8076ducc/robocup-2023/electrical design/symbols and footprints/STM32F103CBT6/STM32F103CBT6.step

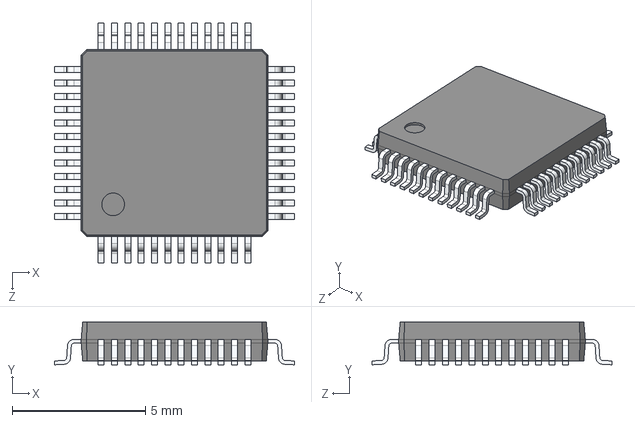
[picture p16: CAD file, 2022-08-24]
electrical design/symbols and footprints/STM32F103CBT6/STM32F103CBT6.step
9.00 x 1.60 x 9.00 mm
