8076ducc/robocup-2023/electrical design/symbols and footprints/VNH5050A-E/VNH5050A-E.step

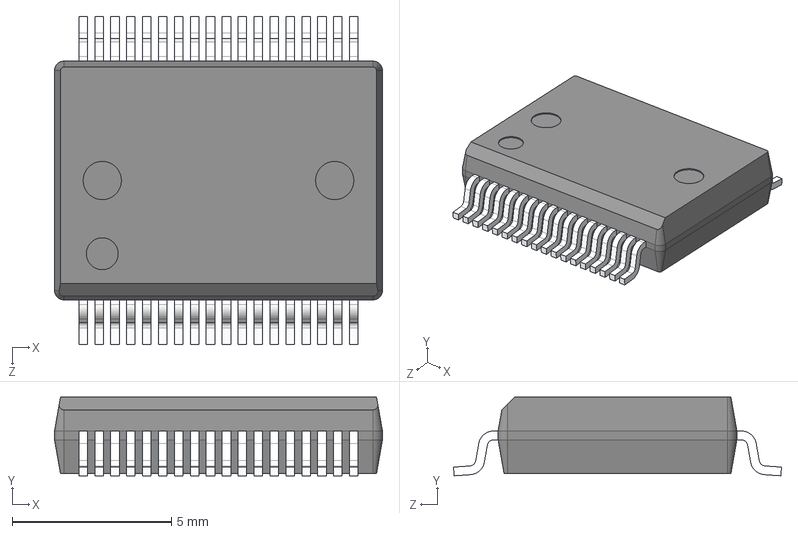
[picture p17: CAD file, 2022-08-24]
electrical design/symbols and footprints/VNH5050A-E/VNH5050A-E.step
10.3 x 2.47 x 10.3 mm
