8076ducc/robocup-2023/electrical design/symbols and footprints/XT60PW-M/XT60PW-M.step

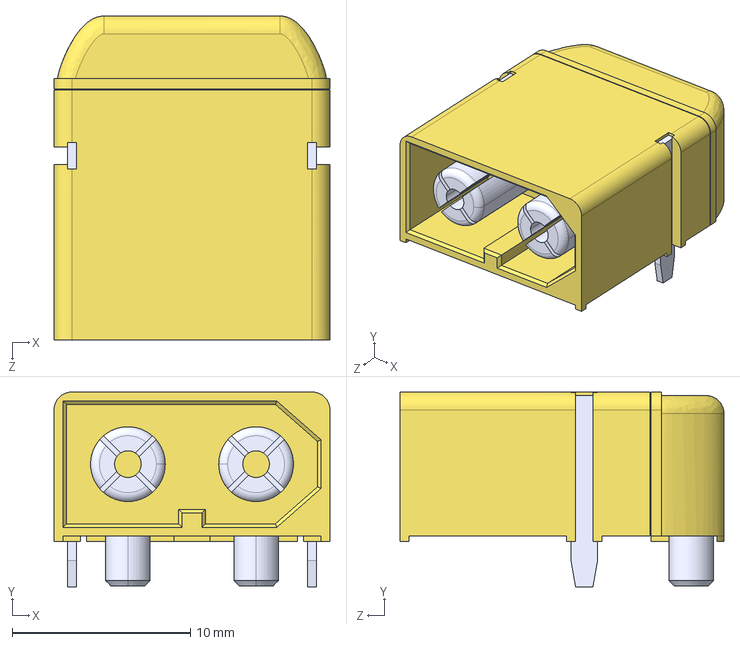
[picture p18: CAD file, 2023-02-03]
electrical design/symbols and footprints/XT60PW-M/XT60PW-M.step
15.5 x 10.9 x 18.2 mm
