8076ducc/robocup-2023/mechanical design/boards/driver.dxf

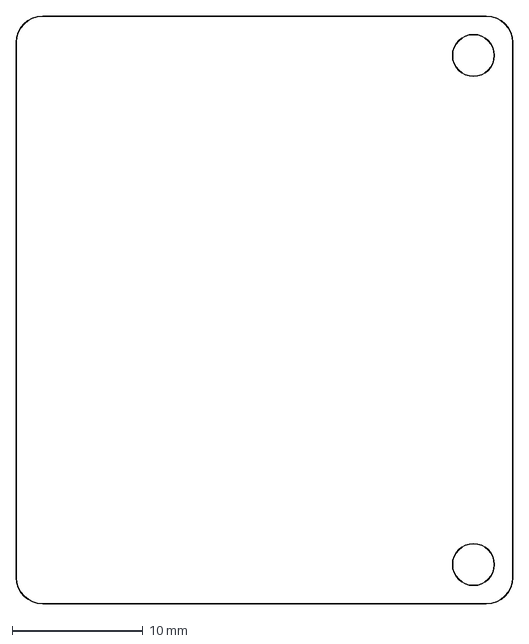
[picture p19: CAD file, 2023-04-10]
mechanical design/boards/driver.dxf
38.0 x 45.0 mm
