8076ducc/robocup-2023/mechanical design/dribbler/right-plate.stl

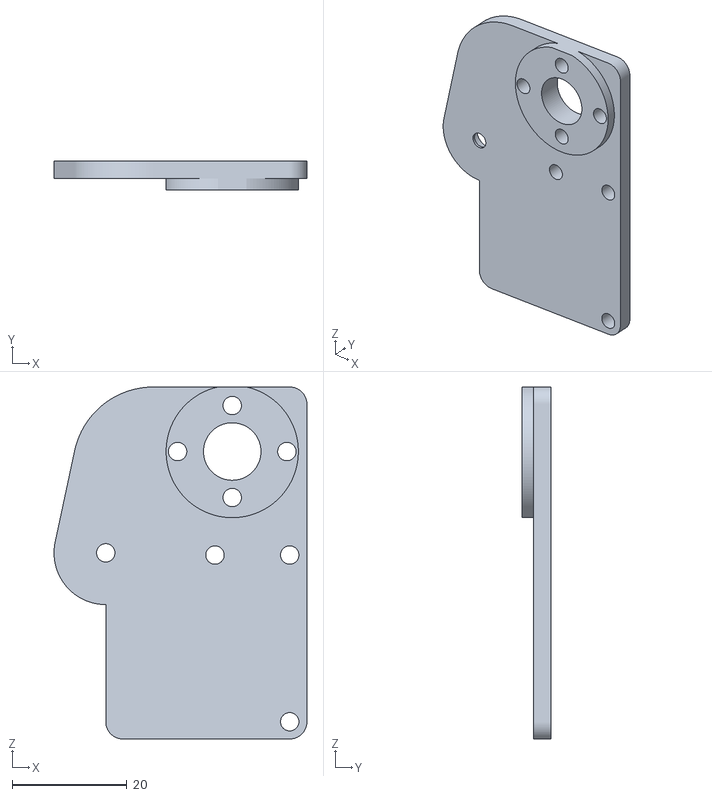
[picture p20: CAD file, 2022-08-31]
mechanical design/dribbler/right-plate.stl
44.0 x 5.00 x 61.2
