8076ducc/robocup-2023/mechanical design/motor mount/motor mount (lower half).stl

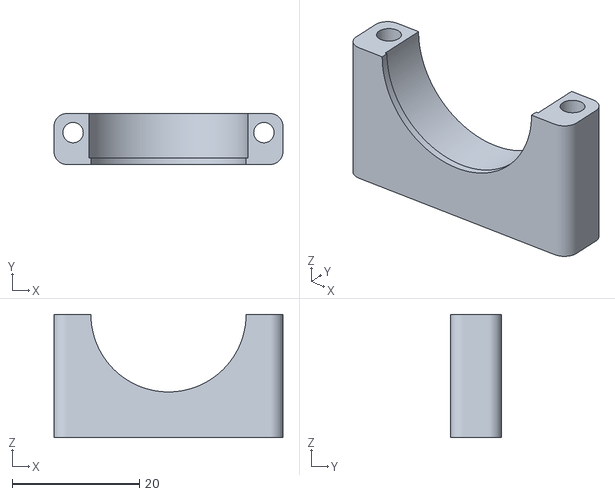
[picture p21: CAD file, 2023-04-07]
mechanical design/motor mount/motor mount (lower half).stl
36.0 x 8.00 x 19.4
