8076ducc/robocup-2023/mechanical design/omniwheel/roller.stl

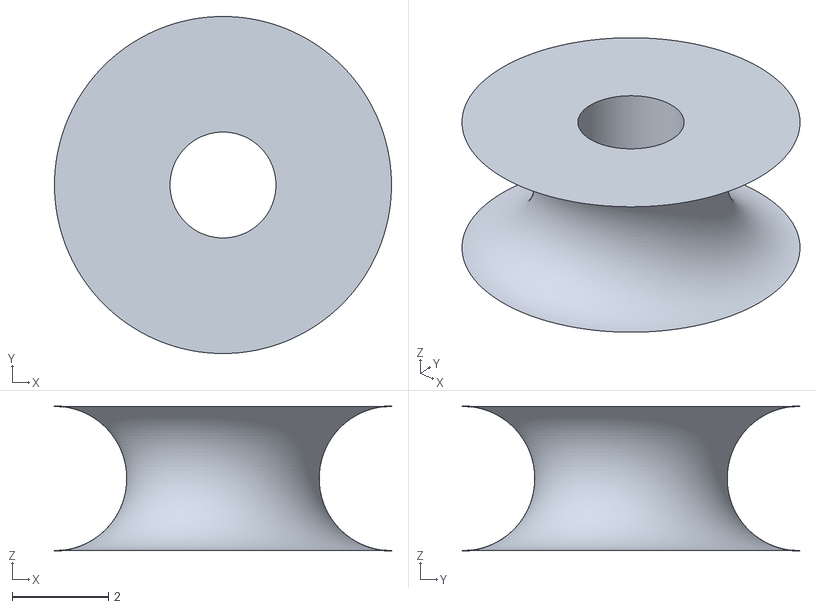
[picture p22: CAD file, 2023-04-07]
mechanical design/omniwheel/roller.stl
7.00 x 7.00 x 3.00
