8076ducc/robocup-2023/mechanical design/boards/layer5.dxf

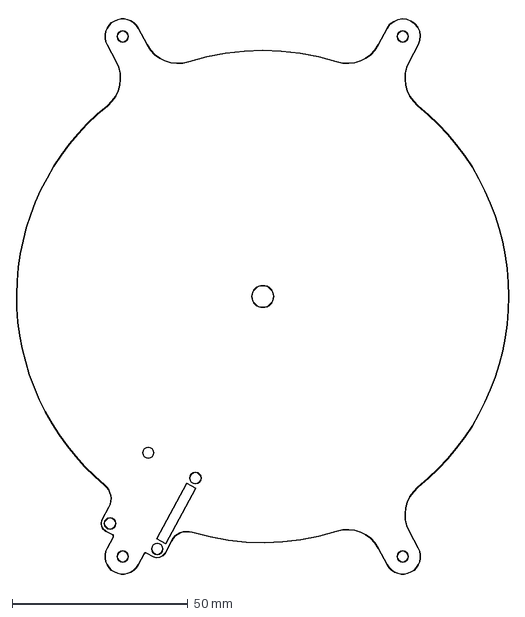
[picture p23: CAD file, 2023-04-10]
mechanical design/boards/layer5.dxf
140.1 x 159.3 mm
