8076ducc/robocup-2023/mechanical design/dribbler/left-plate.stl

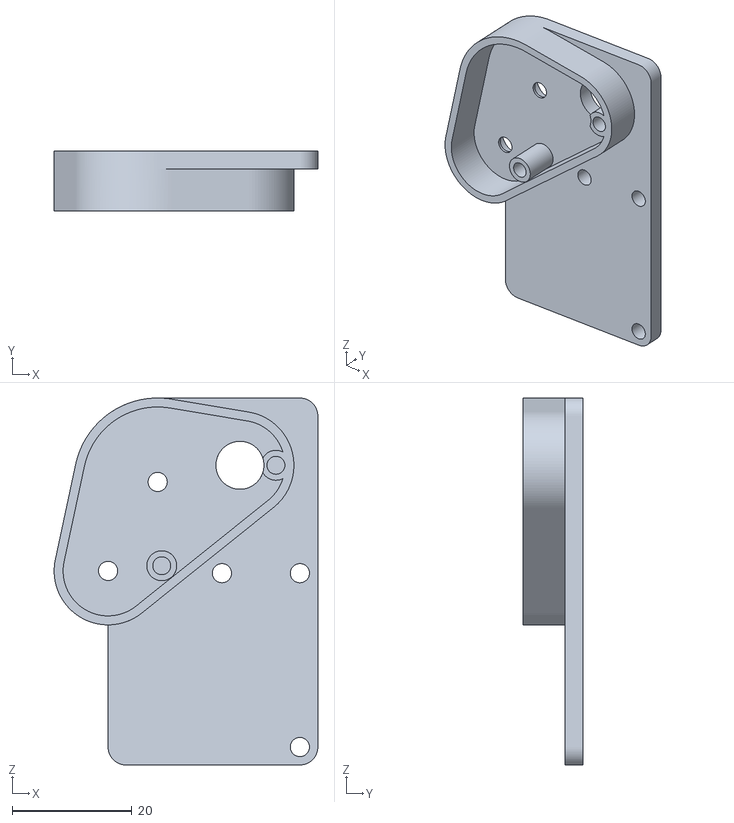
[picture p24: CAD file, 2022-08-26]
mechanical design/dribbler/left-plate.stl
44.0 x 10.0 x 61.2
