8076ducc/robocup-2023/mechanical design/motor mount/motor mount (upper half).stl

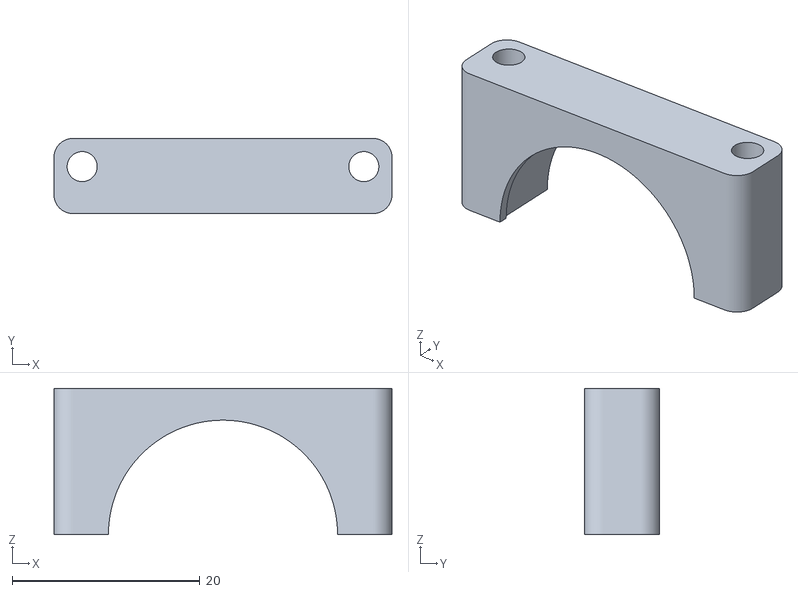
[picture p25: CAD file, 2023-04-07]
mechanical design/motor mount/motor mount (upper half).stl
36.0 x 8.00 x 15.6
