8076ducc/robocup-2023/mechanical design/omniwheel/omniwheel layer 3.stl

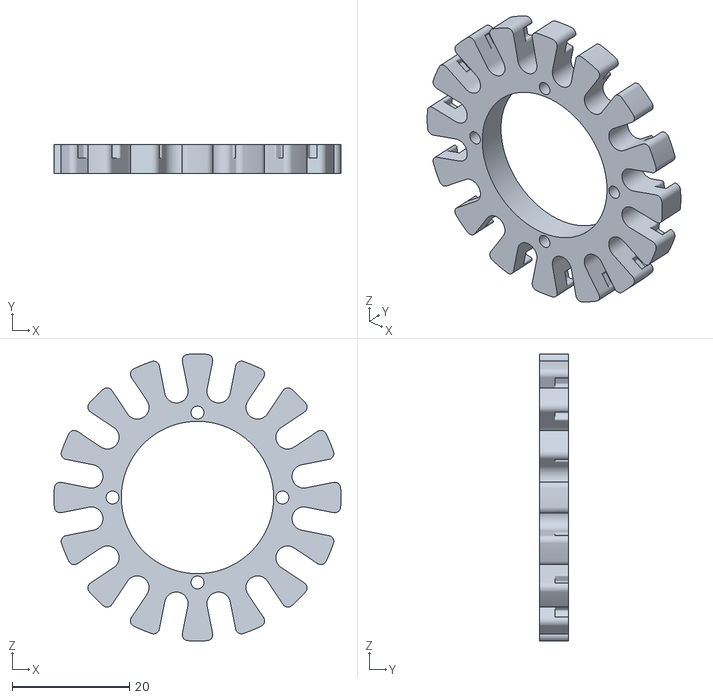
[picture p26: CAD file, 2023-04-07]
mechanical design/omniwheel/omniwheel layer 3.stl
49.0 x 5.00 x 49.0
