8076ducc/robocup-2023/mechanical design/boards/layer1.dxf

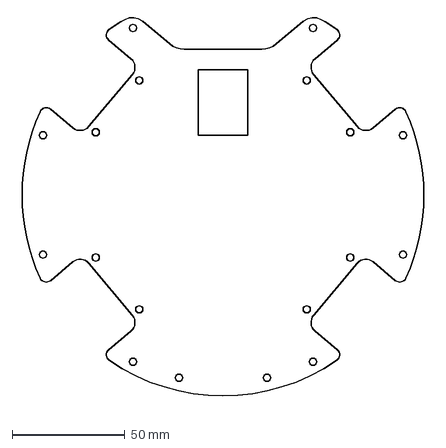
[picture p27: CAD file, 2023-02-15]
mechanical design/boards/layer1.dxf
183.3 x 173.3 mm
