8076ducc/robocup-2023/mechanical design/dribbler/gearbox-cover.stl

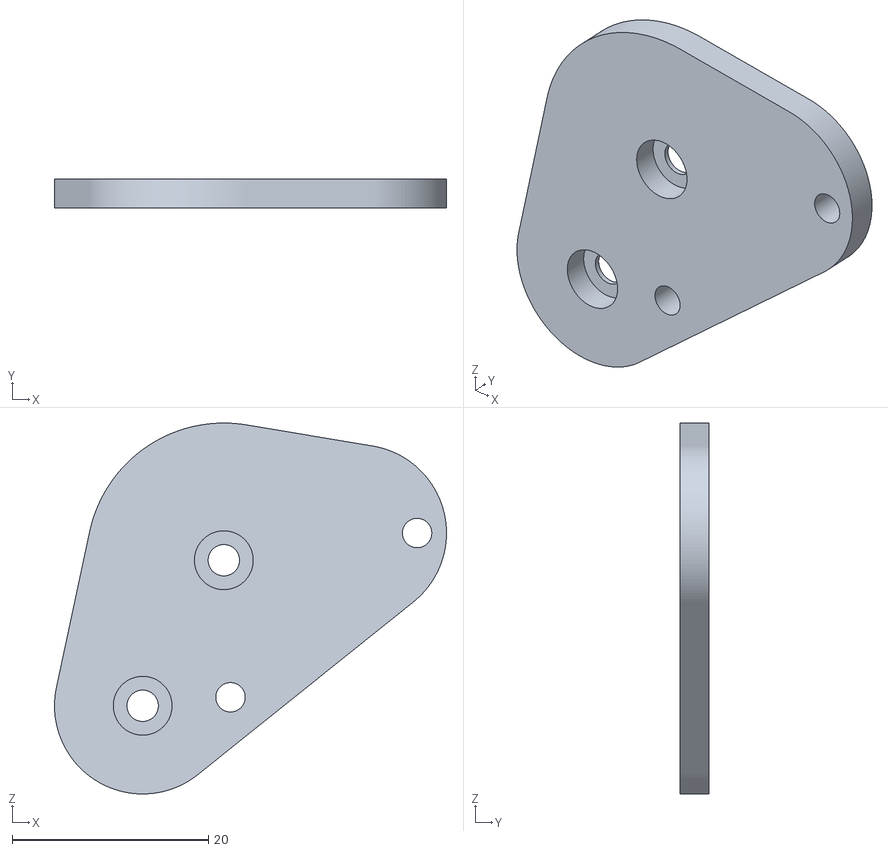
[picture p28: CAD file, 2022-08-26]
mechanical design/dribbler/gearbox-cover.stl
40.0 x 3.00 x 37.8
