8076ducc/robocup-2023/mechanical design/omniwheel/omniwheel layer 1.stl

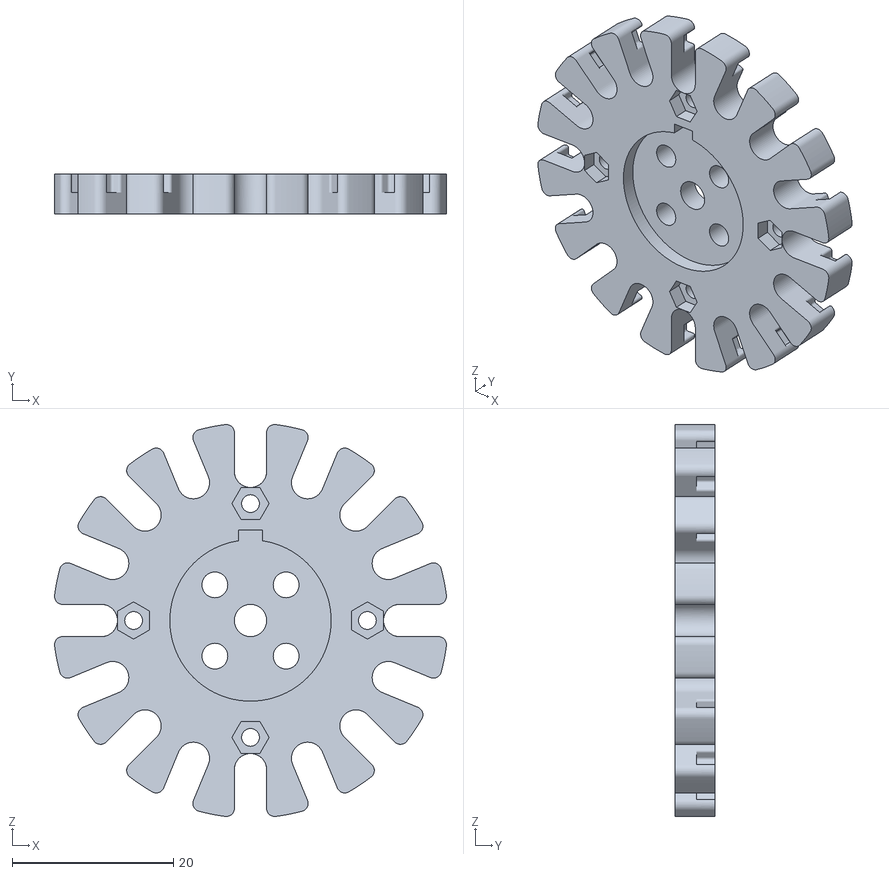
[picture p29: CAD file, 2023-04-07]
mechanical design/omniwheel/omniwheel layer 1.stl
48.6 x 5.00 x 48.6
