8076ducc/robocup-2023/mechanical design/boards/layer3.dxf

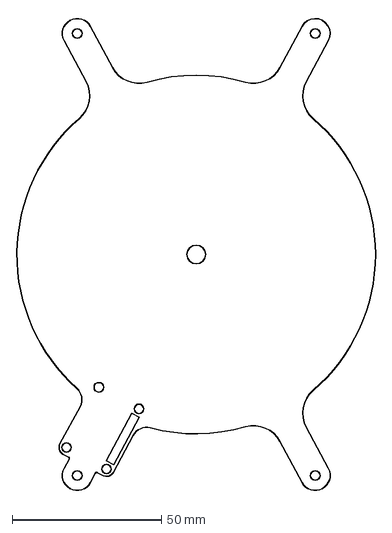
[picture p30: CAD file, 2023-02-15]
mechanical design/boards/layer3.dxf
120.2 x 159.3 mm
