8076ducc/robocup-2023/mechanical design/omniwheel/omniwheel layer 4.stl

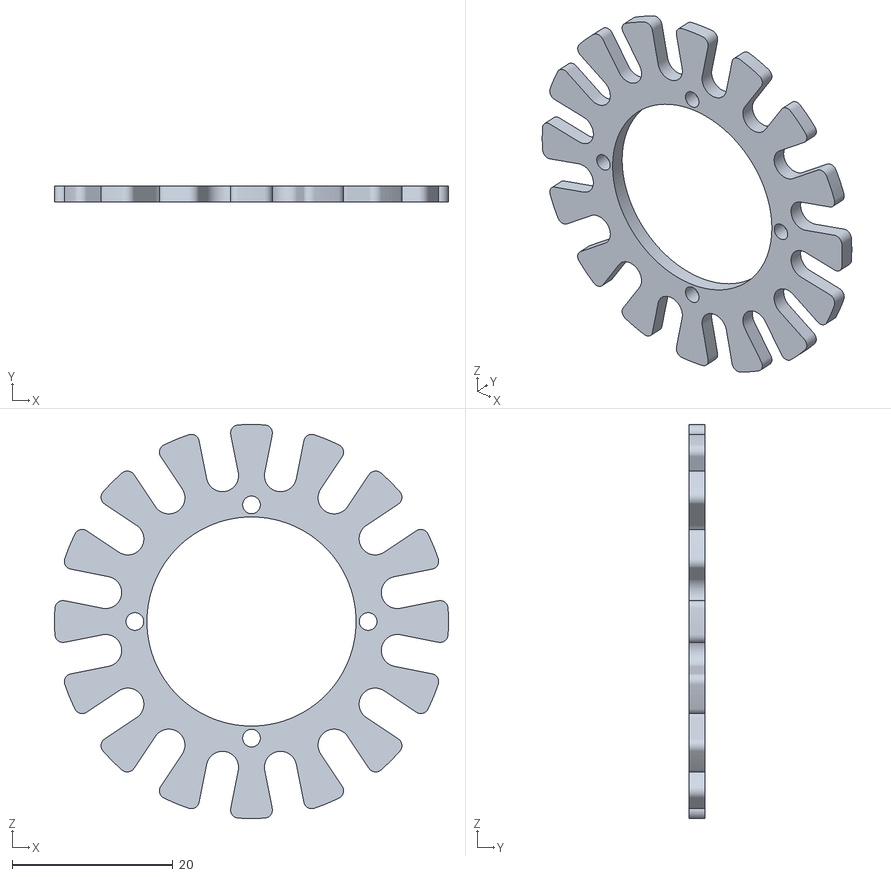
[picture p31: CAD file, 2023-04-07]
mechanical design/omniwheel/omniwheel layer 4.stl
49.0 x 2.00 x 49.0
