8076ducc/robocup-2023/(list of files, cad)

Other CAD files:
mechanical design/omniwheel/omniwheel layer 2.stl
