8076ducc/robocup-2023/electrical design/driver/pcb (back).pdf

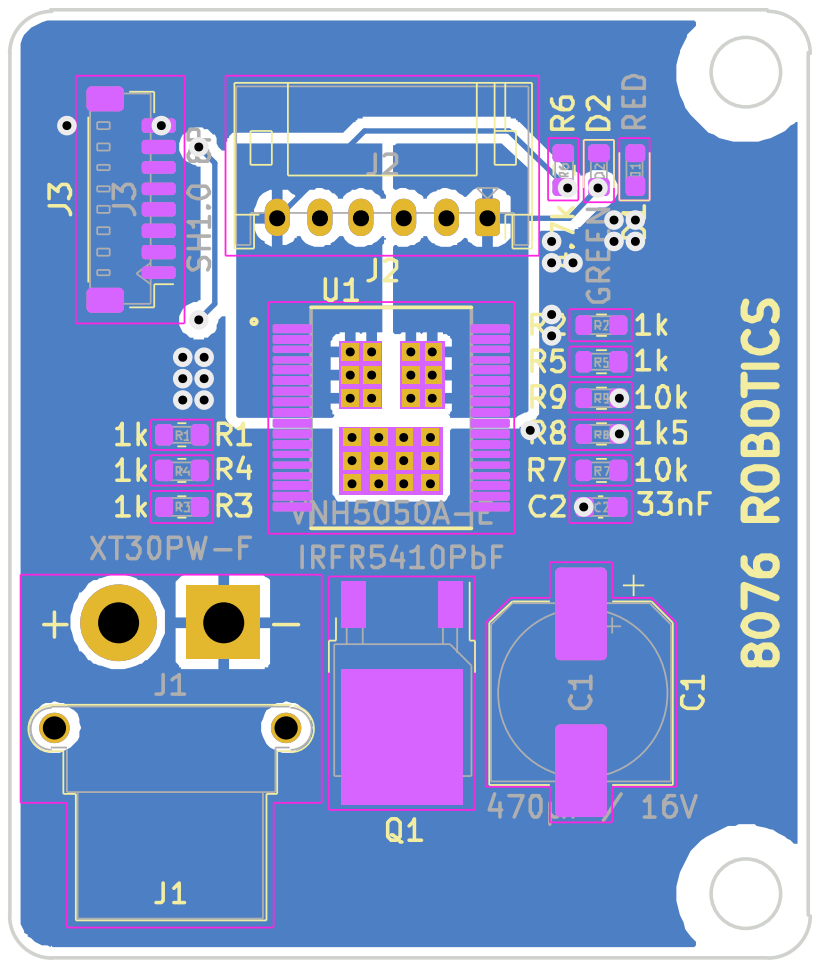
[picture p33: page 1]
