8076ducc/robocup-2023/electrical design/driver/pcb (front).pdf

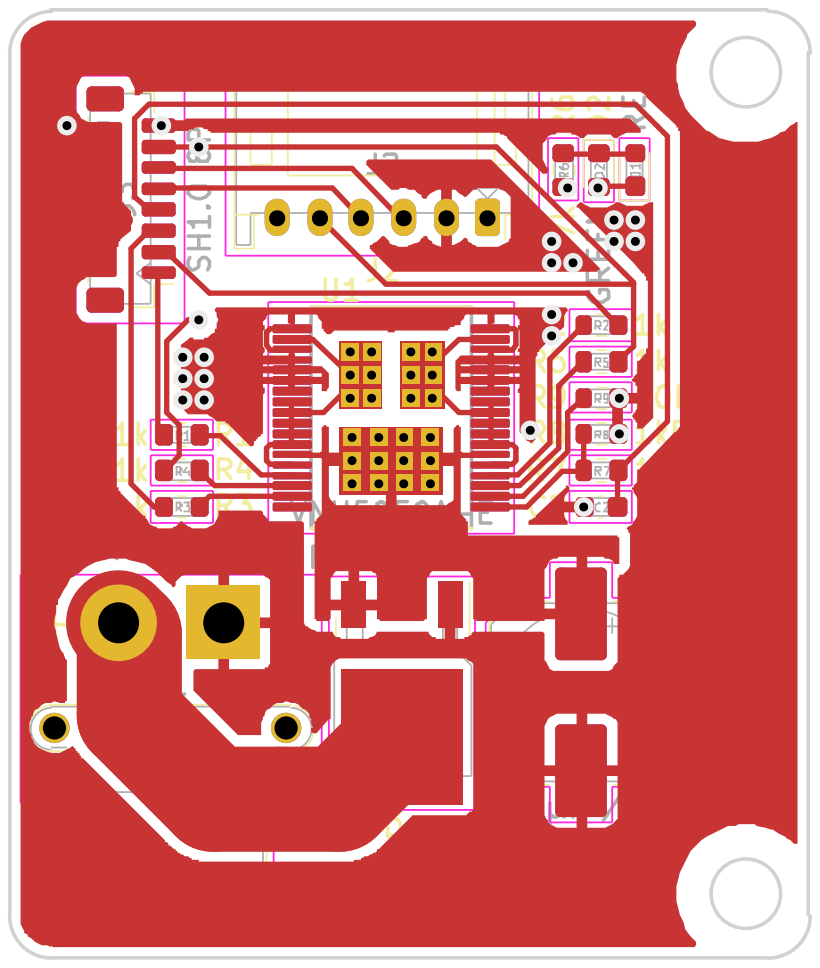
[picture p34: page 1]
