8076ducc/robocup-2023/electrical design/driver/sch.pdf

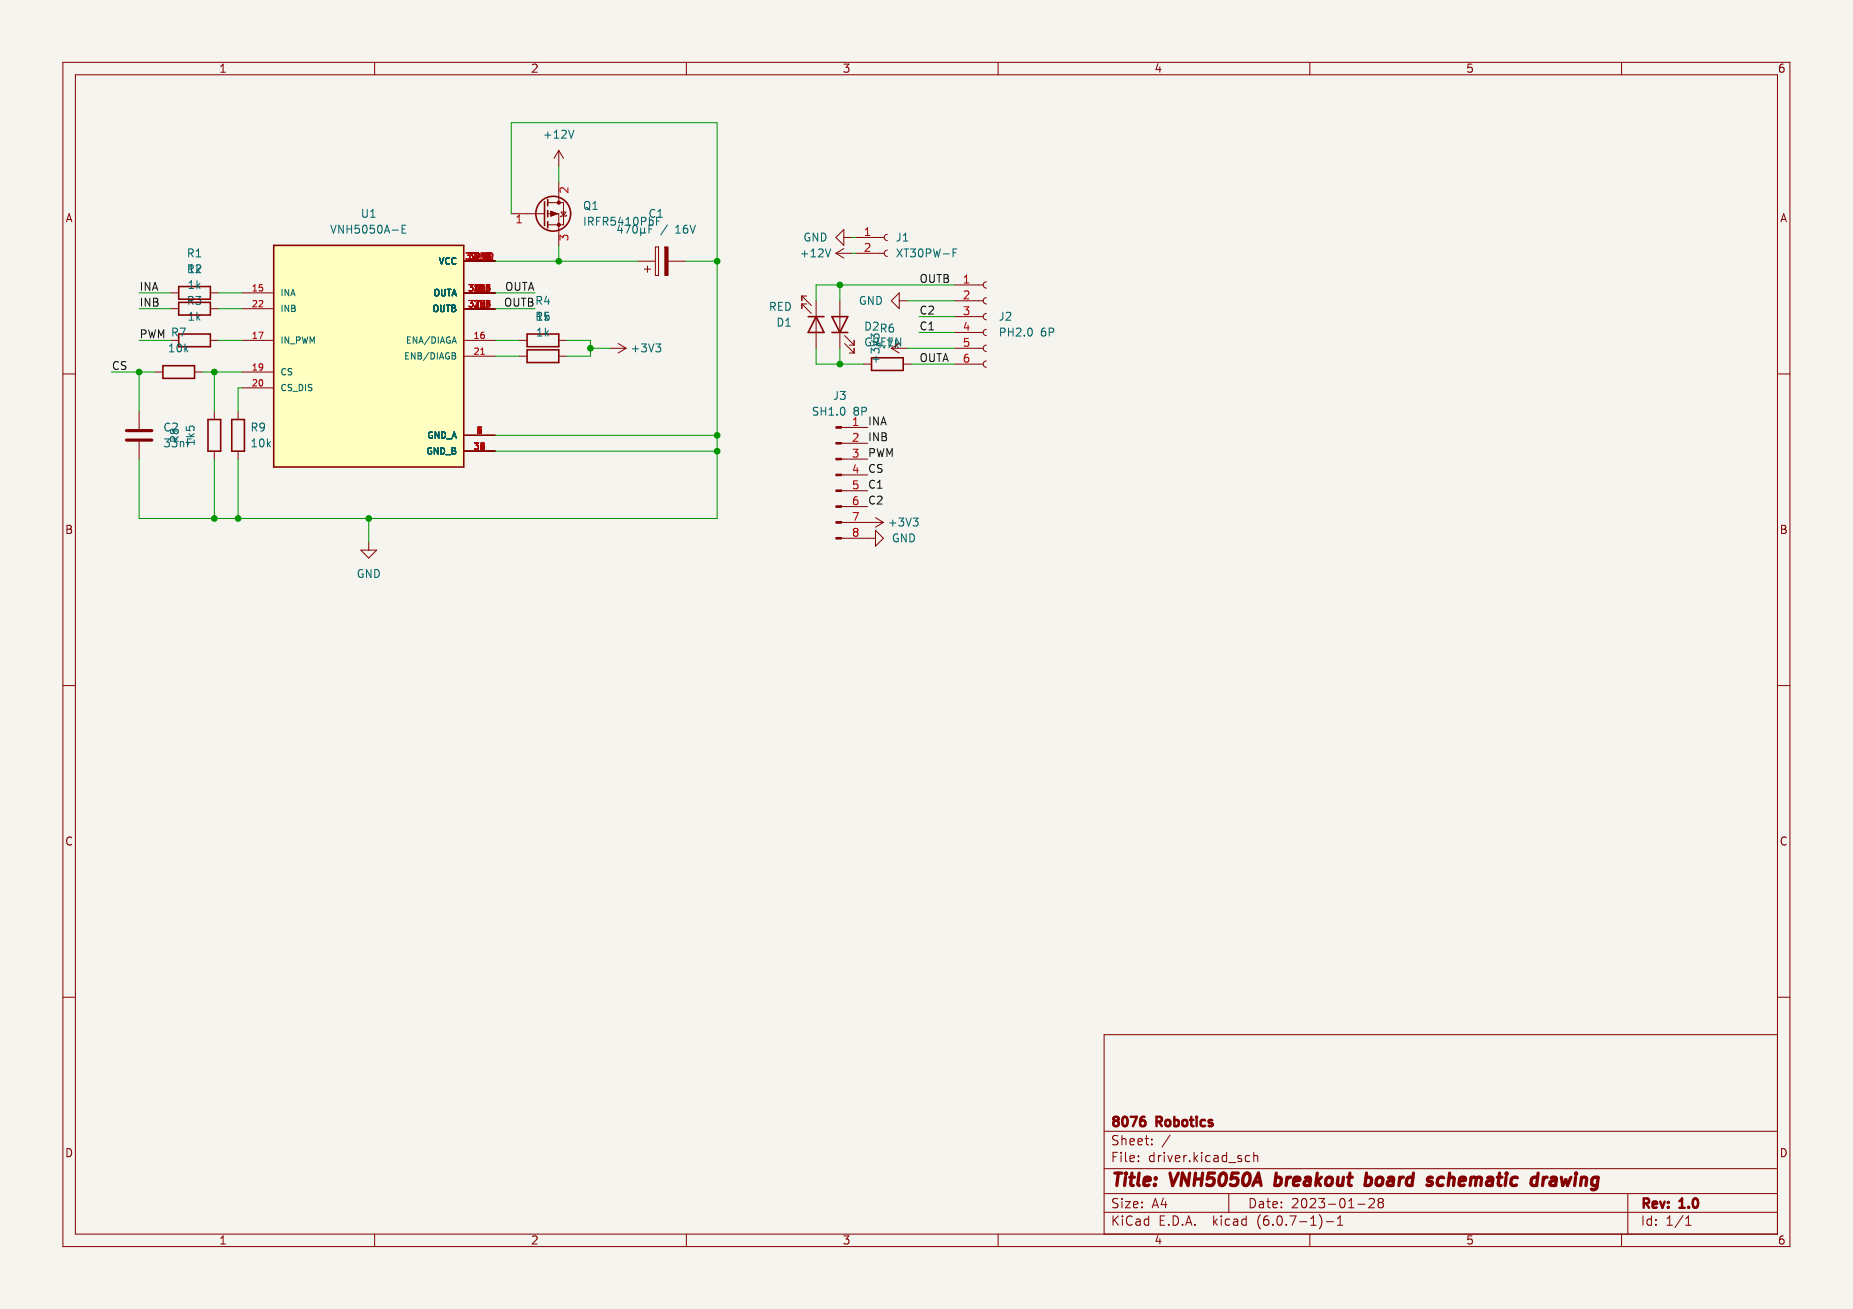
[picture p35: page 1]
