8076ducc/robocup-2023/electrical design/driver/driver.kicad_pcb

## KiCad design electrical design/driver/driver.kicad_pcb (2023-04-17)

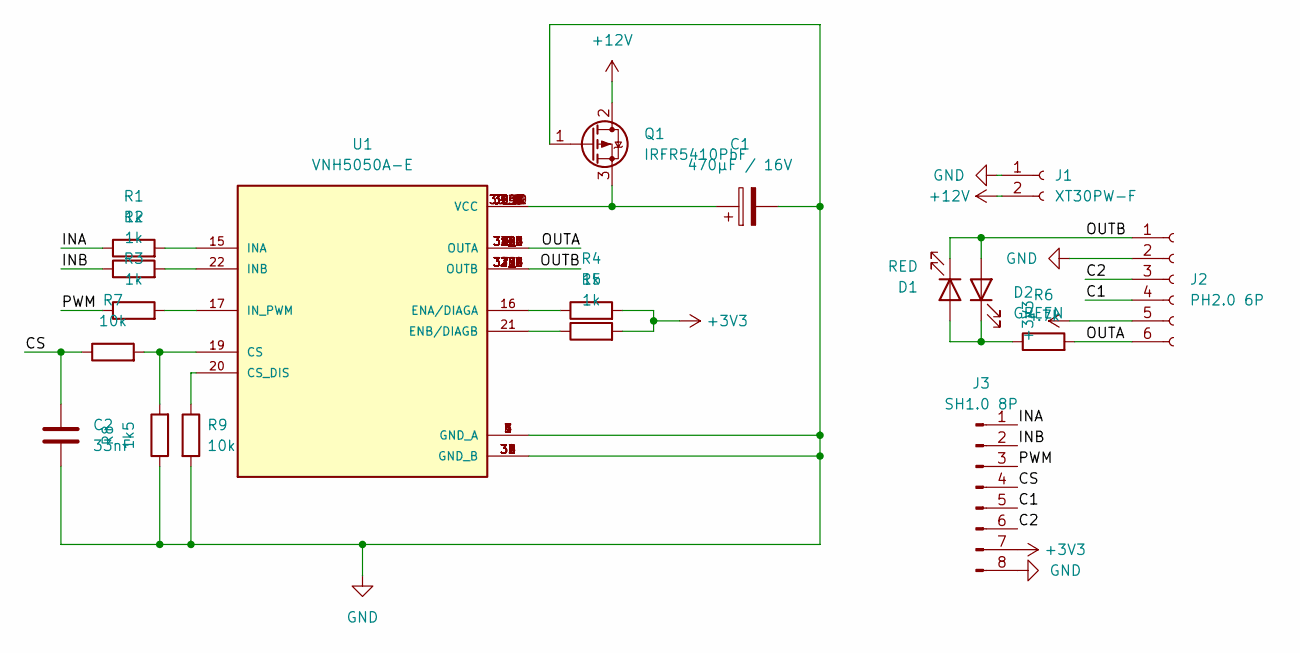
[picture p36: schematic driver.kicad_sch, VNH5050A breakout board schematic drawing]

Parts:
C1: 470µF / 16V; CP_Elec_8x10.5
C2: 33nF; C_0603_1608Metric
D1: RED; D_0603_1608Metric
D2: GREEN; D_0603_1608Metric
J1: XT30PW-F; AMASS_XT30PW-F_1x02_P2.50mm_Horizontal
J2: PH2.0 6P; JST_PH_S6B-PH-K_1x06_P2.00mm_Horizontal
J3: SH1.0 8P; JST_SH_BM08B-SRSS-TB_1x08-1MP_P1.00mm_Vertical
Q1: IRFR5410PbF; TO-252-2
R1, R2, R3, R4, R5: 1k; R_0603_1608Metric
R6: 4.7k; R_0603_1608Metric
R7, R9: 10k; R_0603_1608Metric
R8: 1k5; R_0603_1608Metric
U1: VNH5050A-E; SOP50P1030X247-39N; PARTREV 1.0

Connections:
+3V3: J2.5, J3.7, R4.2, R5.2
+12V: J1.2, Q1.2 (D)
/C1: J2.4, J3.5
/C2: J2.3, J3.6
/CS: C2.1, J3.4, R7.1
/INA: J3.1, R1.1
/INB: J3.2, R2.1
/OUTA: J2.6, R6.2, U1.2 (OUTA), U1.8 (OUTA), U1.9 (OUTA), U1.10 (OUTA), U1.11 (OUTA), U1.12 (OUTA), U1.14 (OUTA), U1.38 (OUTA), U1.38_1 (OUTA), U1.38_2 (OUTA), U1.38_3 (OUTA), U1.38_4 (OUTA), U1.38_5 (OUTA), U1.38_6 (OUTA)
/OUTB: D1.1 (K), D2.2 (A), J2.1, U1.23 (OUTB), U1.25 (OUTB), U1.26 (OUTB), U1.27 (OUTB), U1.28 (OUTB), U1.29 (OUTB), U1.35 (OUTB), U1.37 (OUTB), U1.37_1 (OUTB), U1.37_2 (OUTB), U1.37_3 (OUTB), U1.37_4 (OUTB), U1.37_5 (OUTB), U1.37_6 (OUTB)
/PWM: J3.3, R3.1
GND: C1.2, C2.2, J1.1, J2.2, J3.8, Q1.1 (G), R8.1, R9.2, U1.1 (GND_A), U1.3 (GND_A), U1.4 (GND_A), U1.5 (GND_A), U1.6 (GND_A), U1.7 (GND_A), U1.30 (GND_B), U1.31 (GND_B), U1.32 (GND_B), U1.33 (GND_B), U1.34 (GND_B), U1.36 (GND_B)
unnamed: C1.1, Q1.3 (S), U1.13 (VCC), U1.24 (VCC), U1.39 (VCC), U1.39_1 (VCC), U1.39_2 (VCC), U1.39_3 (VCC), U1.39_4 (VCC), U1.39_5 (VCC), U1.39_6 (VCC), U1.39_7 (VCC), U1.39_8 (VCC), U1.39_9 (VCC), U1.39_10 (VCC), U1.39_11 (VCC), U1.39_12 (VCC)
unnamed: D1.2 (A), D2.1 (K), R6.1
unnamed: R1.2, U1.15 (INA)
unnamed: R2.2, U1.22 (INB)
unnamed: R3.2, U1.17 (IN_PWM)
unnamed: R4.1, U1.16 (ENA/DIAGA)
unnamed: R5.1, U1.21 (ENB/DIAGB)
unnamed: R7.2, R8.2, U1.19 (CS)
unnamed: R9.1, U1.20 (CS_DIS)

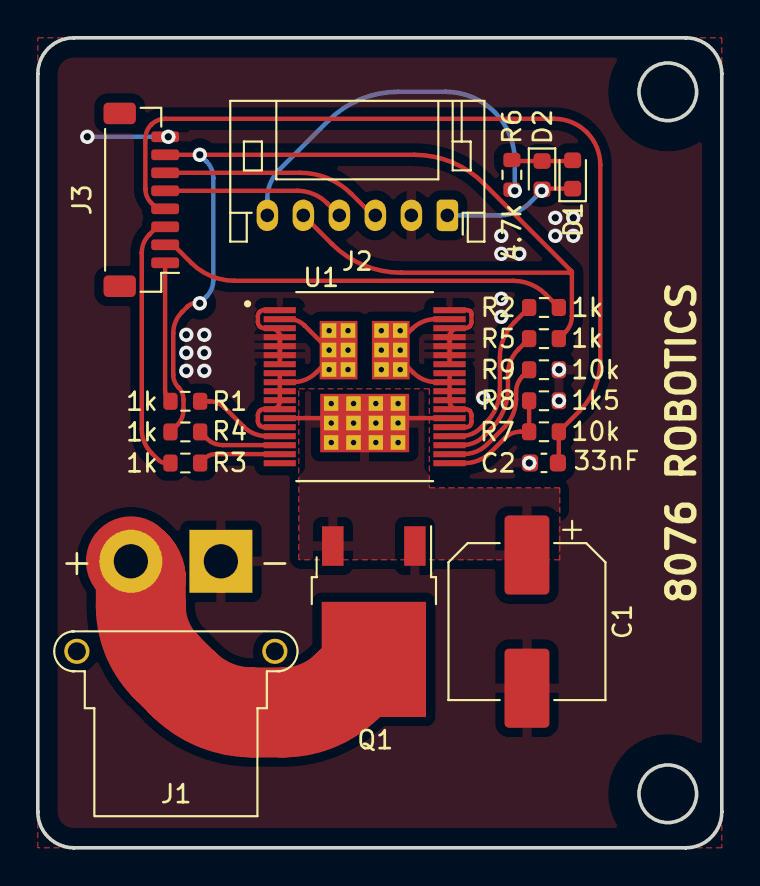
[picture p37: board driver.kicad_pcb from above]

Board: 2 copper layers, 38.0 x 45.0 mm, 18 parts (0 on the bottom side), 20 nets.
