8076ducc/robocup-2023/electrical design/layer3/layer3.kicad_pcb

## KiCad design electrical design/layer3/layer3.kicad_pcb (2023-04-17)

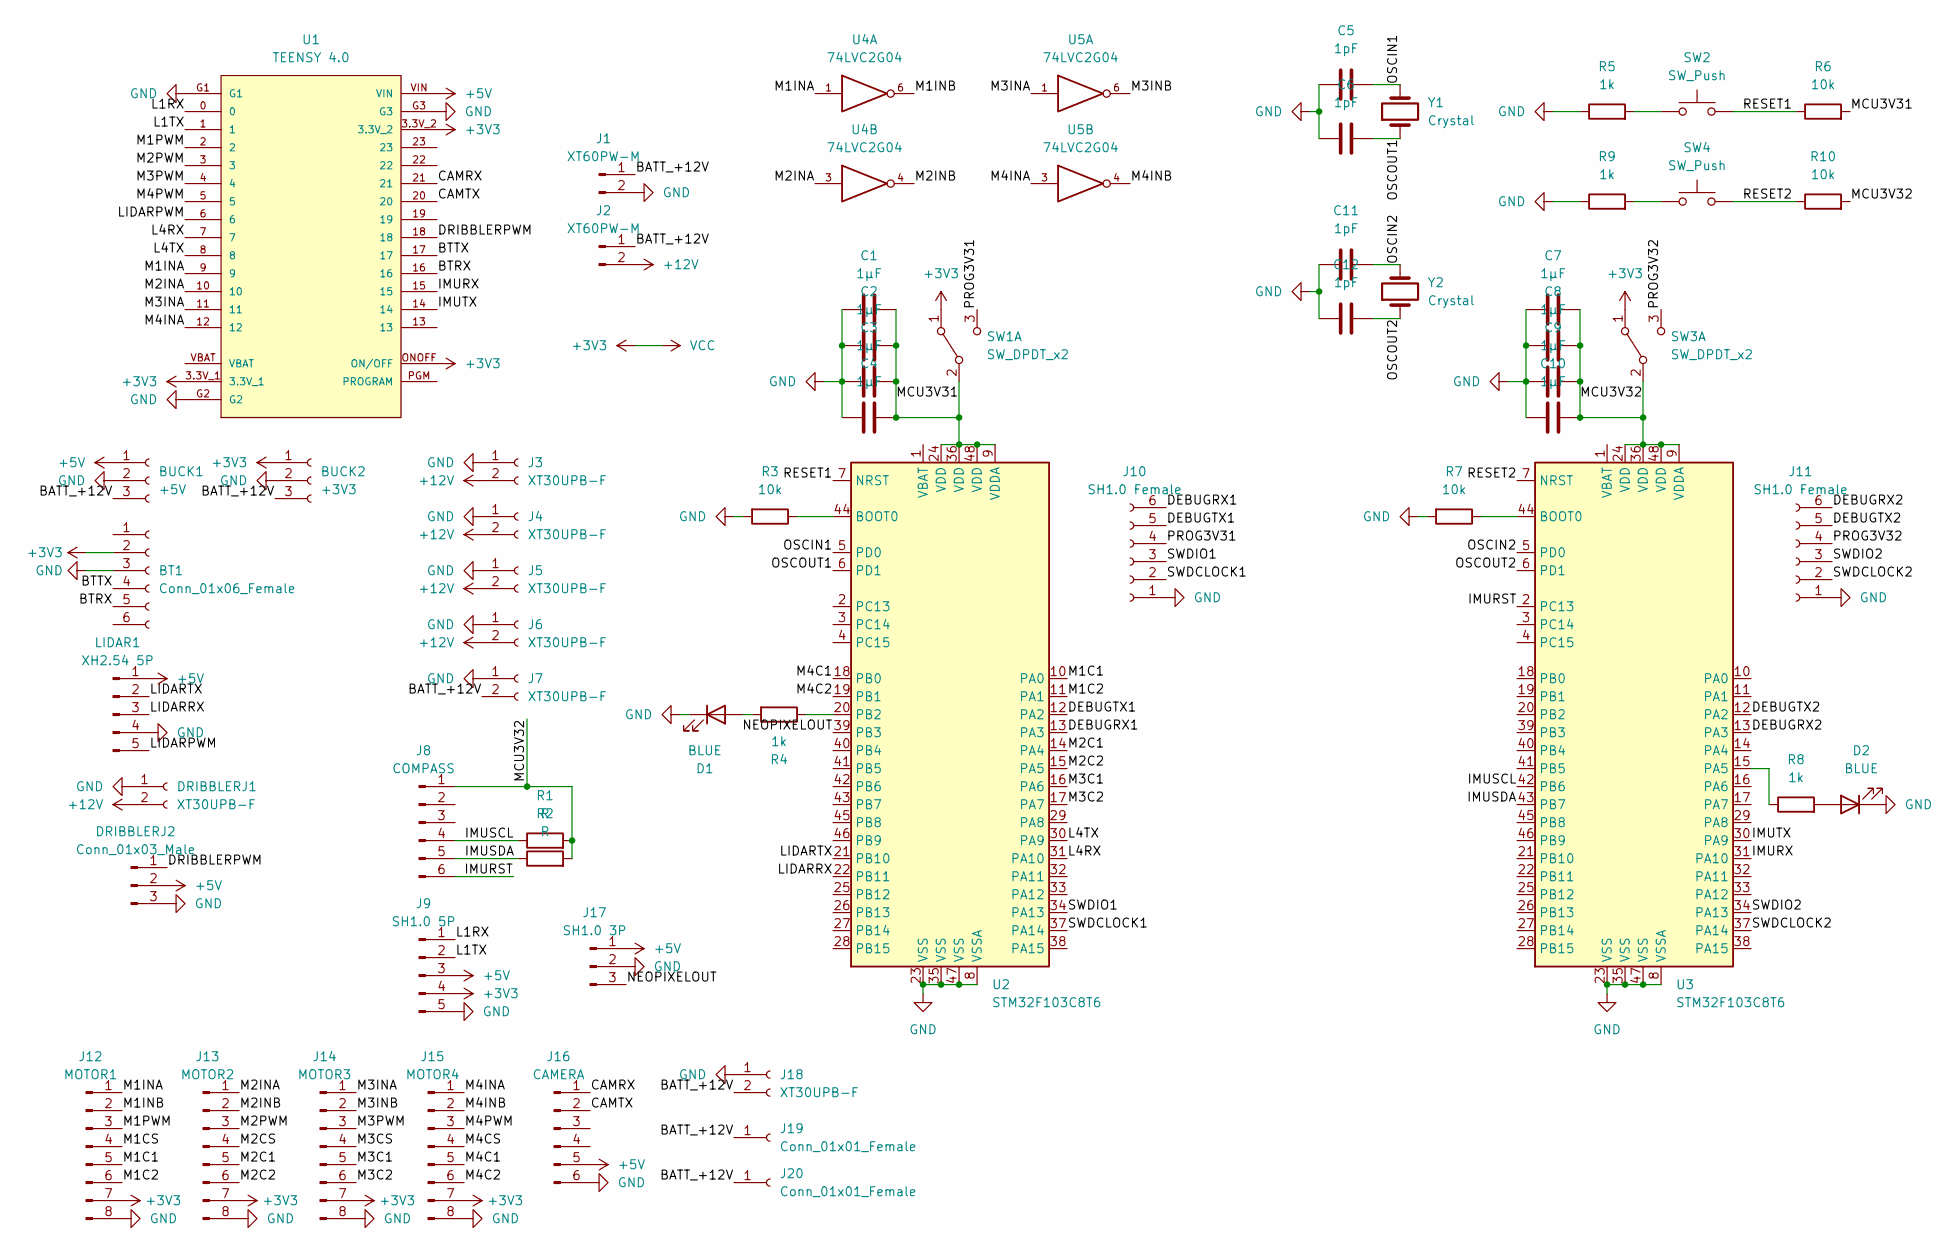
[picture p40: schematic layer3.kicad_sch, layer 3 schematic drawing]

Parts:
BT1: Conn_01x06_Female; PinSocket_1x06_P2.54mm_Horizontal
BUCK1: +5V; PinHeader_1x03_P2.54mm_Vertical
BUCK2: +3V3; PinHeader_1x03_P2.54mm_Vertical
C1, C2, C3, C4, C7, C8, C9, C10: 1μF; C_0603_1608Metric
C5, C6, C11, C12: 1pF; C_0603_1608Metric
D1, D2: BLUE; D_0603_1608Metric
DRIBBLERJ1: XT30UPB-F; AMASS_XT30UPB-F_1x02_P5.0mm_Vertical
DRIBBLERJ2: Conn_01x03_Male; PinHeader_1x03_P2.54mm_Vertical
J1, J2: XT60PW-M; AMASS_XT60PW-M
J3, J4, J5, J6, J7, J18: XT30UPB-F; AMASS_XT30UPB-F_1x02_P5.0mm_Vertical
J8: COMPASS; PinHeader_1x06_P2.54mm_Vertical
J9: SH1.0 5P; JST_SH_BM05B-SRSS-TB_1x05-1MP_P1.00mm_Vertical
J10, J11: SH1.0 Female; JST_SH_BM06B-SRSS-TB_1x06-1MP_P1.00mm_Vertical
J12: MOTOR1; JST_SH_BM08B-SRSS-TB_1x08-1MP_P1.00mm_Vertical
J13: MOTOR2; JST_SH_BM08B-SRSS-TB_1x08-1MP_P1.00mm_Vertical
J14: MOTOR3; JST_SH_BM08B-SRSS-TB_1x08-1MP_P1.00mm_Vertical
J15: MOTOR4; JST_SH_BM08B-SRSS-TB_1x08-1MP_P1.00mm_Vertical
J16: CAMERA; JST_GH_SM06B-GHS-TB_1x06-1MP_P1.25mm_Horizontal
J17: SH1.0 3P; JST_SH_BM03B-SRSS-TB_1x03-1MP_P1.00mm_Vertical
J19, J20: Conn_01x01_Female; SolderWire-1.5sqmm_1x01_D1.7mm_OD3.9mm
LIDAR1: XH2.54 5P; JST_XH_B5B-XH-A_1x05_P2.50mm_Vertical
R1, R2: R; R_0603_1608Metric
R3, R6, R7, R10: 10k; R_0603_1608Metric
R4, R5, R8, R9: 1k; R_0603_1608Metric
SW1, SW3: SW_DPDT_x2; SWITCH_SPDT_PTH_11.6X4.0MM_LOCK
SW2, SW4: SW_Push; SW_Push_SPST_NO_Alps_SKRK
U1: TEENSY 4.0; Teensy40
U2, U3: STM32F103C8T6; LQFP-48_7x7mm_P0.5mm
U4, U5: 74LVC2G04; SOT-23-6
Y1, Y2: Crystal; Crystal_SMD_5032-2Pin_5.0x3.2mm

Connections:
+3V3: BT1.2, BUCK2.1, J9.4, J12.7, J13.7, J14.7, J15.7, SW1.1 (A), SW3.1 (A), U1.3.3V_1, U1.3.3V_2, U1.ONOFF (ON/OFF), U4.5 (VCC), U5.5 (VCC)
+5V: BUCK1.1, DRIBBLERJ2.2, J9.3, J16.5, J17.1, LIDAR1.1, U1.VIN
+12V: DRIBBLERJ1.2, J2.2, J3.2, J4.2, J5.2, J6.2
/BATT_+12V: BUCK1.3, BUCK2.3, J1.1, J2.1, J7.2, J18.2, J19.1, J20.1
/BTRX: BT1.5, U1.16
/BTTX: BT1.4, U1.17
/CAMRX: J16.1, U1.21
/CAMTX: J16.2, U1.20
/DEBUGRX1: J10.6, U2.13 (PA3)
/DEBUGRX2: J11.6, U3.13 (PA3)
/DEBUGTX1: J10.5, U2.12 (PA2)
/DEBUGTX2: J11.5, U3.12 (PA2)
/DRIBBLERPWM: DRIBBLERJ2.1, U1.18
/IMURST: J8.6, U3.2 (PC13)
/IMURX: U1.15, U3.31 (PA10)
/IMUSCL: J8.4, R1.1, U3.42 (PB6)
/IMUSDA: J8.5, R2.1, U3.43 (PB7)
/IMUTX: U1.14, U3.30 (PA9)
/L1RX: J9.1, U1.0
/L1TX: J9.2, U1.1
/L4RX: U1.7, U2.31 (PA10)
/L4TX: U1.8, U2.30 (PA9)
/LIDARPWM: LIDAR1.5, U1.6
/LIDARRX: LIDAR1.3, U2.22 (PB11)
/LIDARTX: LIDAR1.2, U2.21 (PB10)
/M1C1: J12.5, U2.10 (PA0)
/M1C2: J12.6, U2.11 (PA1)
/M1CS: J12.4
/M1INA: J12.1, U1.9, U4.1
/M1INB: J12.2, U4.6
/M1PWM: J12.3, U1.2
/M2C1: J13.5, U2.14 (PA4)
/M2C2: J13.6, U2.15 (PA5)
/M2CS: J13.4
/M2INA: J13.1, U1.10, U4.3
/M2INB: J13.2, U4.4
/M2PWM: J13.3, U1.3
/M3C1: J14.5, U2.16 (PA6)
/M3C2: J14.6, U2.17 (PA7)
/M3CS: J14.4
/M3INA: J14.1, U1.11, U5.1
/M3INB: J14.2, U5.6
/M3PWM: J14.3, U1.4
/M4C1: J15.5, U2.18 (PB0)
/M4C2: J15.6, U2.19 (PB1)
/M4CS: J15.4
/M4INA: J15.1, U1.12, U5.3
/M4INB: J15.2, U5.4
/M4PWM: J15.3, U1.5
/MCU3V31: C1.2, C2.2, C3.2, C4.2, R6.2, SW1.2 (B), U2.9 (VDDA), U2.24 (VDD), U2.36 (VDD), U2.48 (VDD)
/MCU3V32: C7.2, C8.2, C9.2, C10.2, J8.1, R1.2, R2.2, R10.2, SW3.2 (B), U3.9 (VDDA), U3.24 (VDD), U3.36 (VDD), U3.48 (VDD)
/NEOPIXELOUT: J17.3, U2.39 (PB3)
/OSCIN1: C5.2, U2.5 (PD0), Y1.2
/OSCIN2: C11.2, U3.5 (PD0), Y2.2
/OSCOUT1: C6.2, U2.6 (PD1), Y1.1
/OSCOUT2: C12.2, U3.6 (PD1), Y2.1
/PROG3V31: J10.4, SW1.3 (C)
/PROG3V32: J11.4, SW3.3 (C)
/RESET1: R6.1, SW2.2, U2.7 (NRST)
/RESET2: R10.1, SW4.2, U3.7 (NRST)
/SWDCLOCK1: J10.2, U2.37 (PA14)
/SWDCLOCK2: J11.2, U3.37 (PA14)
/SWDIO1: J10.3, U2.34 (PA13)
/SWDIO2: J11.3, U3.34 (PA13)
GND: BT1.3, BUCK1.2, BUCK2.2, C1.1, C2.1, C3.1, C4.1, C5.1, C6.1, C7.1, C8.1, C9.1, C10.1, C11.1, C12.1, D1.1 (K), D2.1 (K), DRIBBLERJ1.1, DRIBBLERJ2.3, J1.2, J3.1, J4.1, J5.1, J6.1, J7.1, J9.5, J10.1, J11.1, J12.8, J13.8, J14.8, J15.8, J16.6, J17.2, J18.1, LIDAR1.4, R3.2, R5.1, R7.2, R9.1, U1.G1, U1.G2, U1.G3, U2.8 (VSSA), U2.23 (VSS), U2.35 (VSS), U2.47 (VSS), U3.8 (VSSA), U3.23 (VSS), U3.35 (VSS), U3.47 (VSS), U4.2 (GND), U5.2 (GND)
unnamed: D1.2 (A), R4.2
unnamed: D2.2 (A), R8.2
unnamed: R3.1, U2.44 (BOOT0)
unnamed: R4.1, U2.20 (PB2)
unnamed: R5.2, SW2.1
unnamed: R7.1, U3.44 (BOOT0)
unnamed: R8.1, U3.15 (PA5)
unnamed: R9.2, SW4.1

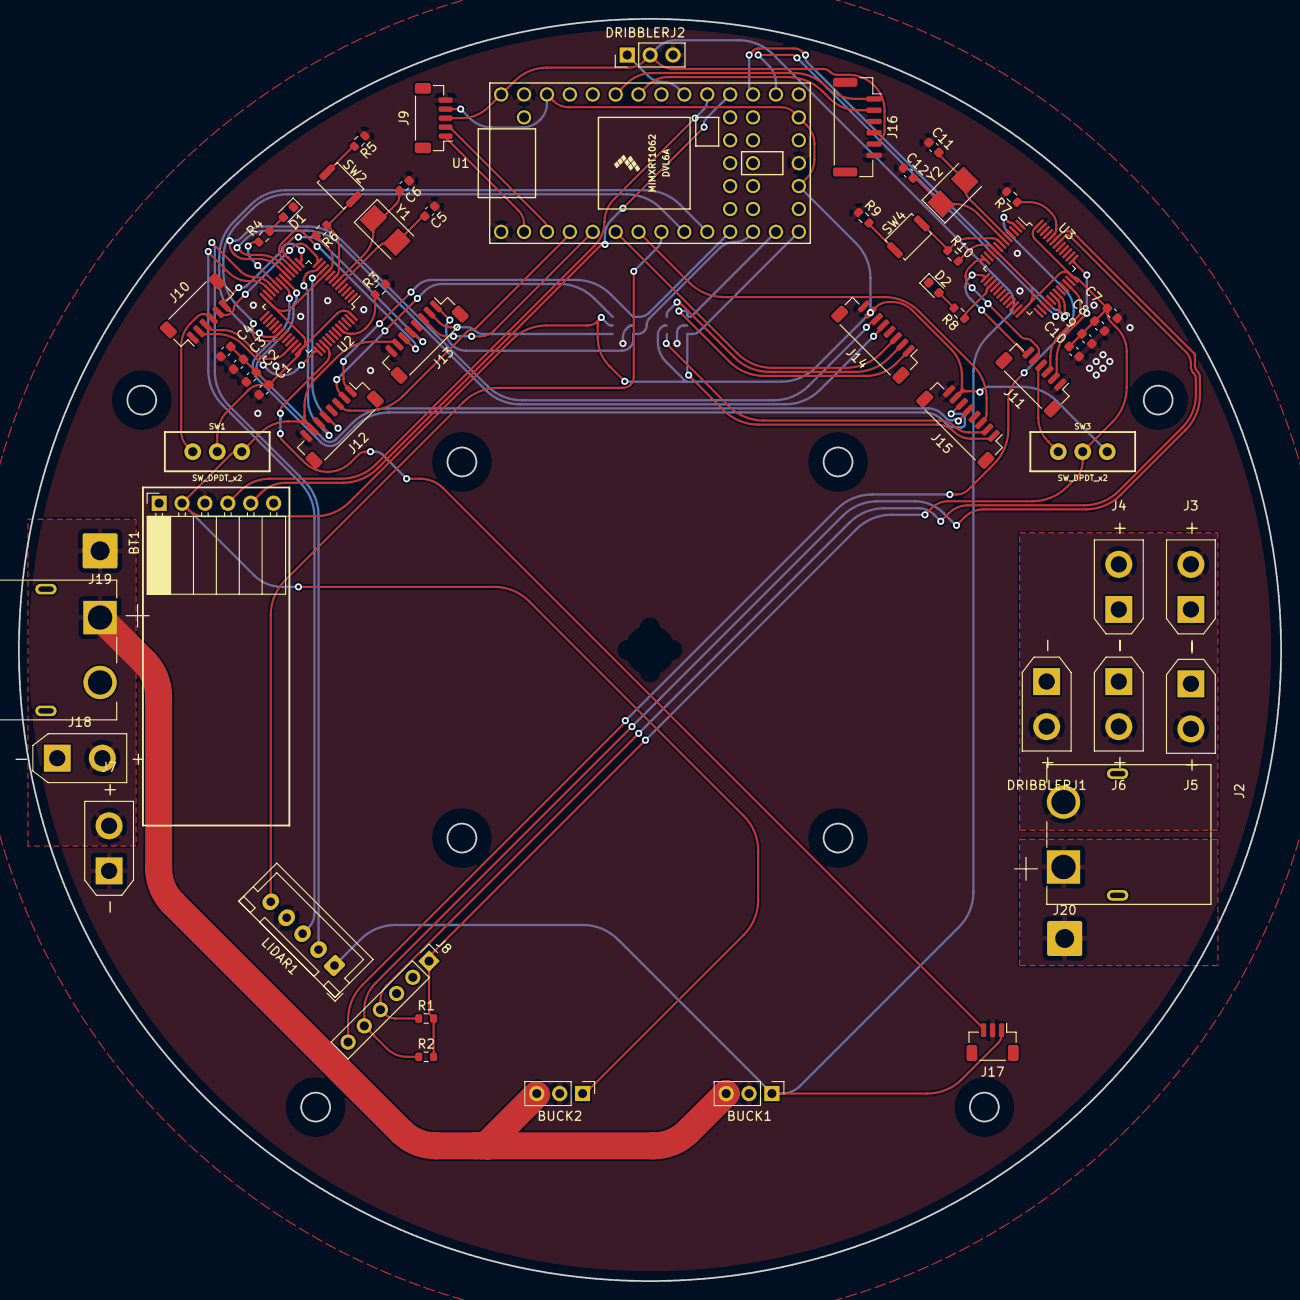
[picture p41: board layer3.kicad_pcb from above]

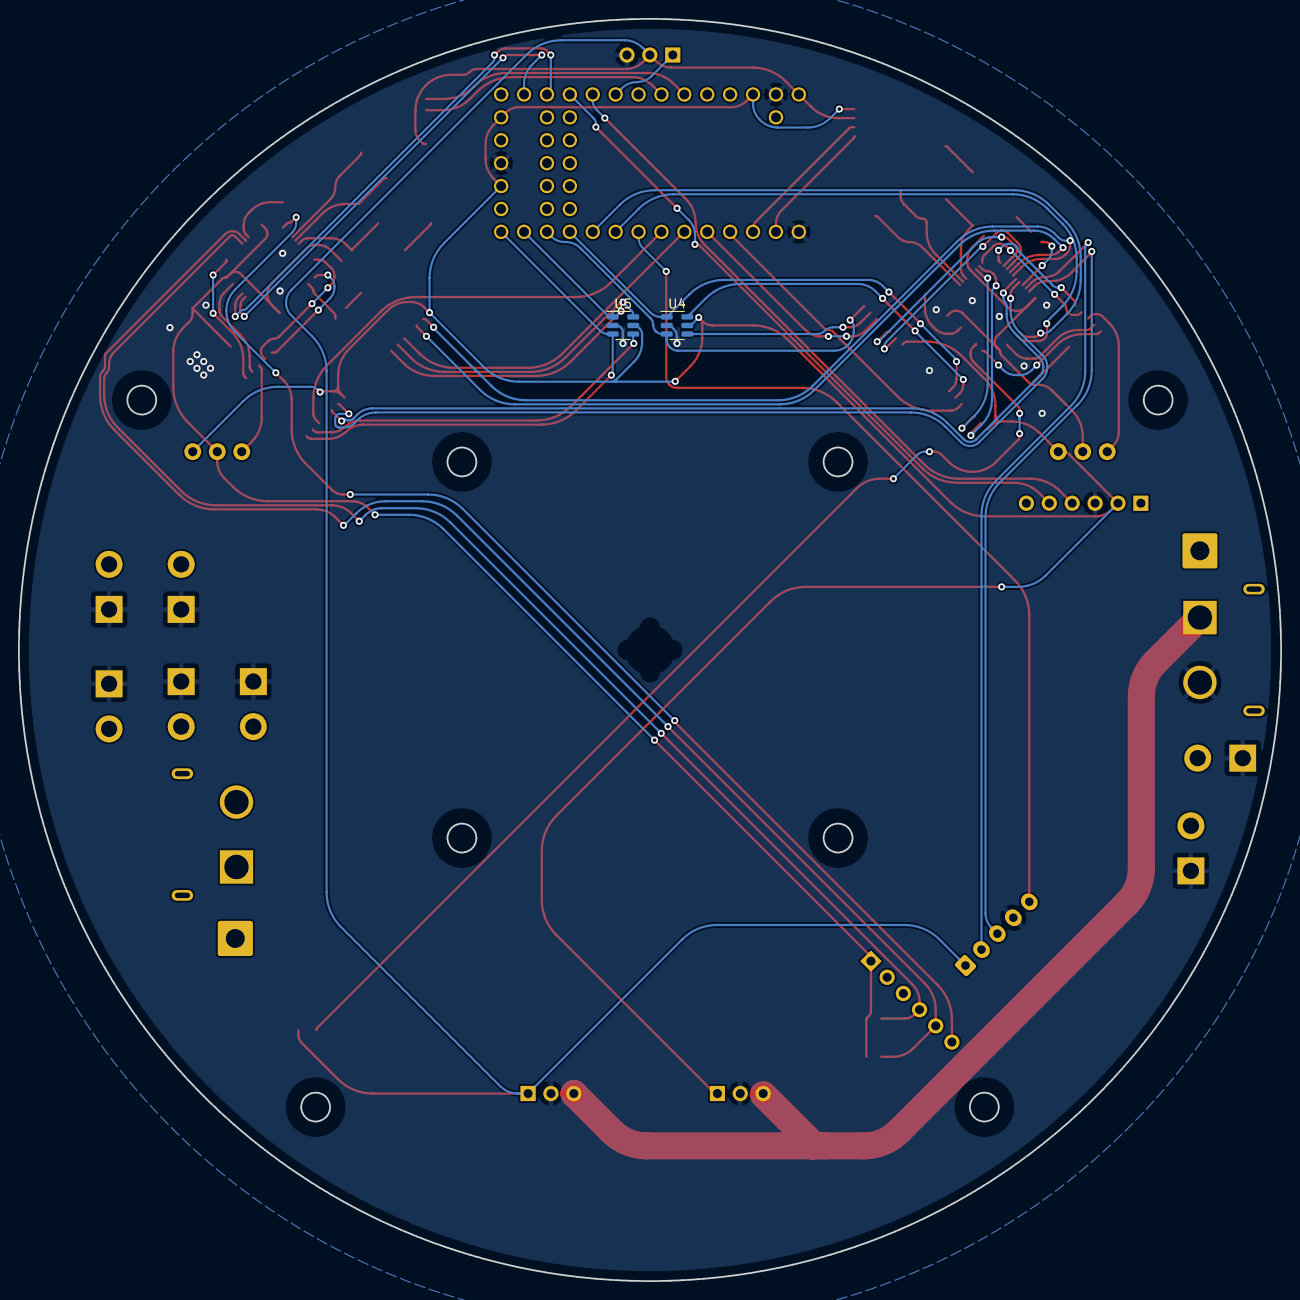
[picture p42: board layer3.kicad_pcb from below]

Board: 2 copper layers, 140.0 x 140.0 mm, 61 parts (2 on the bottom side), 69 nets.
