8076ducc/robocup-2023/electrical design/layer1/layer1.kicad_pcb

## KiCad design electrical design/layer1/layer1.kicad_pcb (2023-04-17)

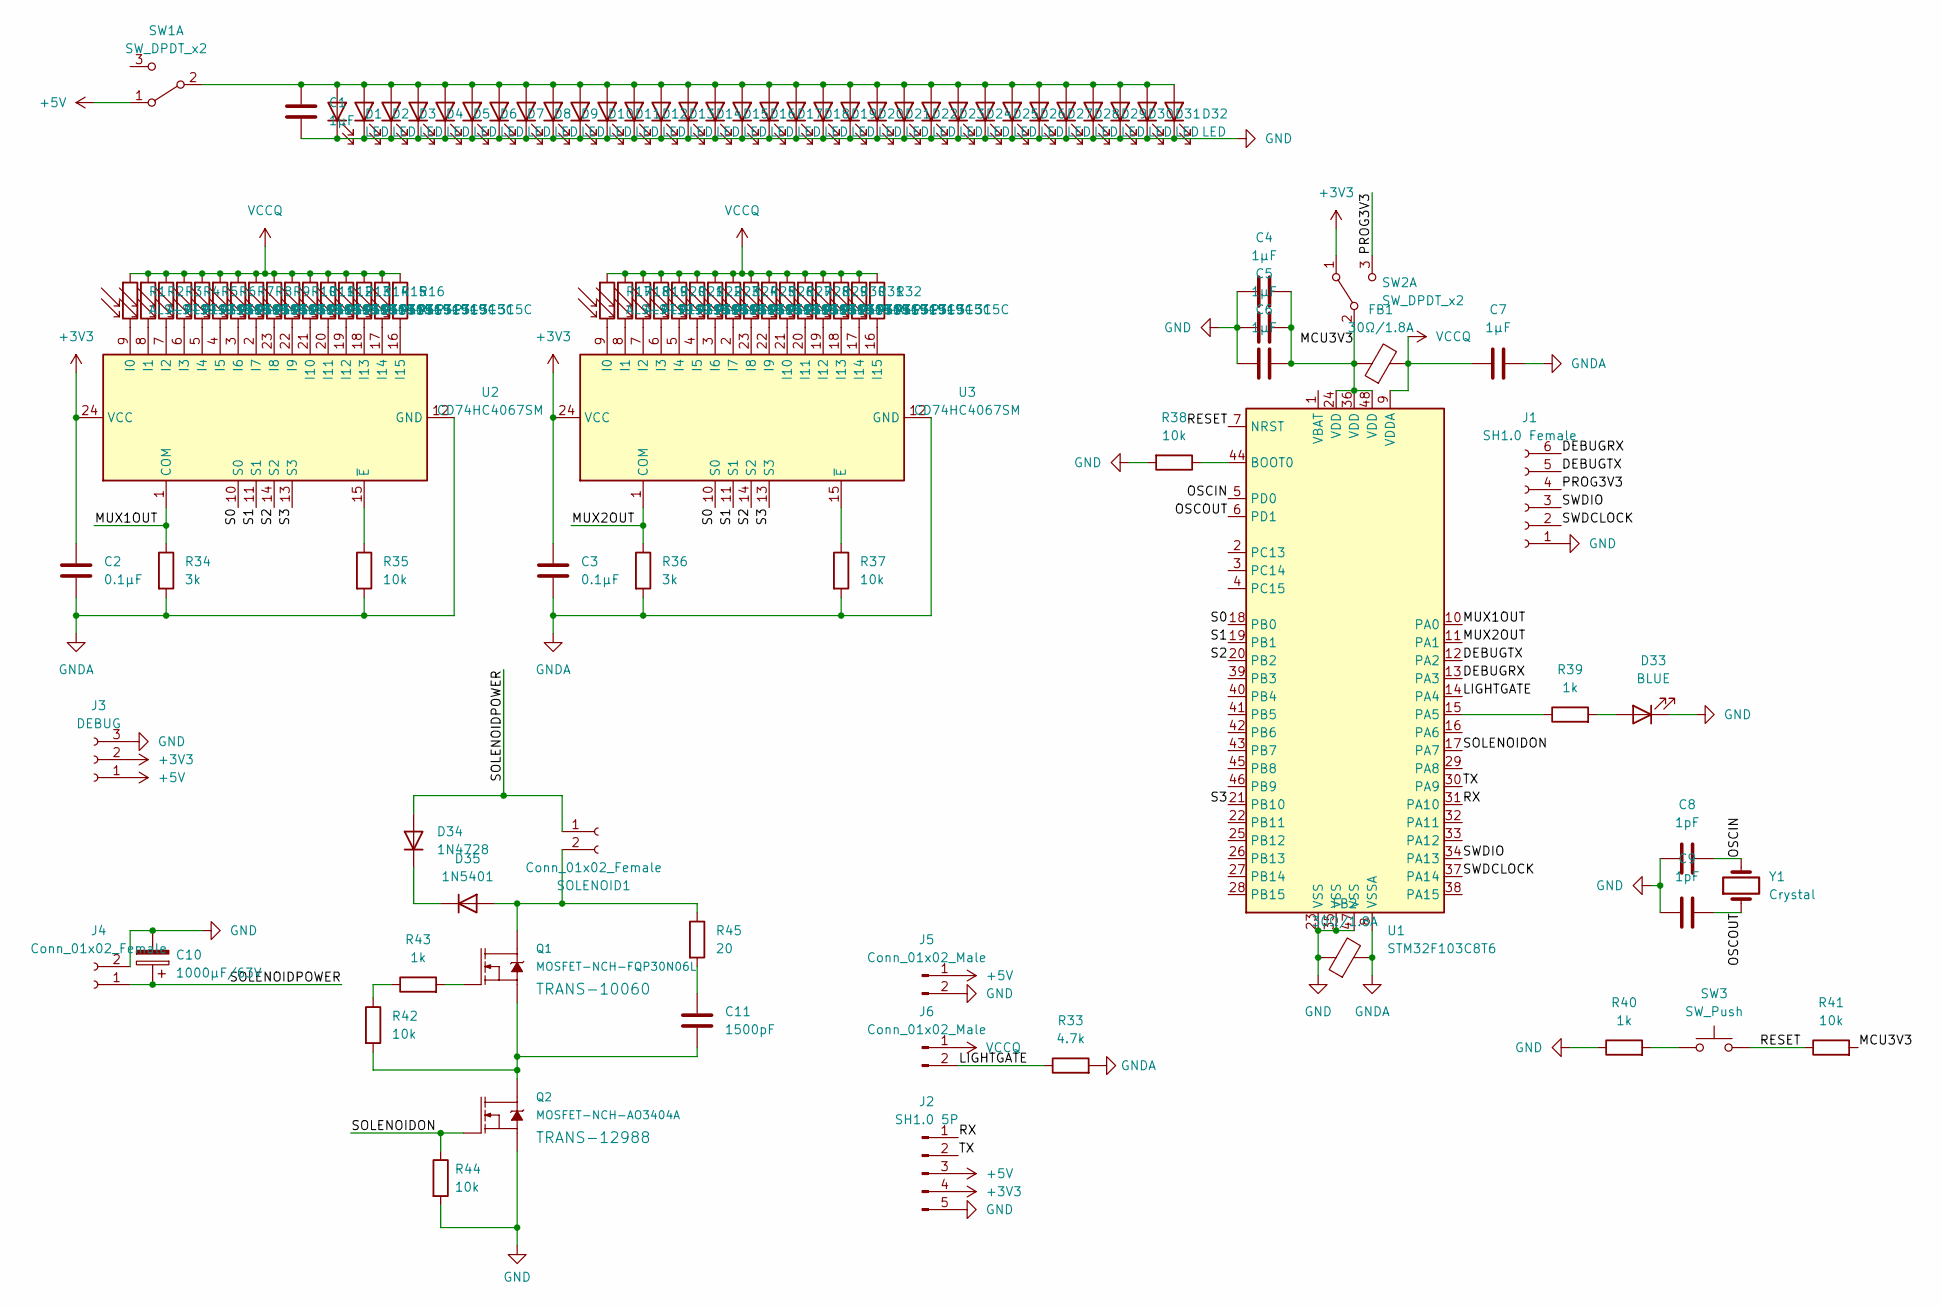
[picture p43: schematic layer1.kicad_sch, layer 1 schematic drawing]

Parts:
C1, C4, C5, C6, C7: 1μF; C_0603_1608Metric
C2, C3: 0.1μF; C_0603_1608Metric
C8, C9: 1pF; C_0603_1608Metric
C10: 1000µF/63V; CP_Radial_D16.0mm_P7.50mm
C11: 1500pF; C_0603_1608Metric
D1, D2, D3, D4, D5, D6, D7, D8, D9, D10, D11, D12, D13, D14, D15, D16, D17, D18, D19, D20, D21, D22, D23, D24, D25, D26, D27, D28, D29, D30, D31, D32: LED; CP_EIA-3528-12_Kemet-T
D33: BLUE; D_0603_1608Metric
D34: 1N4728; D_DO-41_SOD81_P10.16mm_Horizontal
D35: 1N5401; D_DO-27_P15.24mm_Horizontal
FB1, FB2: 30Ω/1.8A; C_0603_1608Metric
J1: SH1.0 Female; JST_SH_BM06B-SRSS-TB_1x06-1MP_P1.00mm_Vertical
J2: SH1.0 5P; JST_SH_BM05B-SRSS-TB_1x05-1MP_P1.00mm_Vertical
J3: DEBUG; PinHeader_1x03_P2.54mm_Vertical
J4: Conn_01x02_Female; AMASS_XT30UPB-F_1x02_P5.0mm_Vertical
J5, J6: Conn_01x02_Male; PinHeader_1x02_P2.54mm_Vertical
Q1: MOSFET-NCH-FQP30N06L; TO-220-3_Vertical
Q2: MOSFET-NCH-AO3404A; TSOT-23
R1, R2, R3, R4, R5, R6, R7, R8, R9, R10, R11, R12, R13, R14, R15, R16, R17, R18, R19, R20, R21, R22, R23, R24, R25, R26, R27, R28, R29, R30, R31, R32: ALS-PT19-315C; R_0603_1608Metric
R33: 4.7k; R_0603_1608Metric
R34, R36: 3k; R_0603_1608Metric
R35, R37, R38, R41, R42, R44: 10k; R_0603_1608Metric
R39, R40, R43: 1k; R_0603_1608Metric
R45: 20; R_0603_1608Metric
SOLENOID1: Conn_01x02_Female; AMASS_XT30UPB-F_1x02_P5.0mm_Vertical
SW1, SW2: SW_DPDT_x2; SWITCH_SPDT_PTH_11.6X4.0MM_LOCK
SW3: SW_Push; SW_Push_SPST_NO_Alps_SKRK
U1: STM32F103C8T6; LQFP-48_7x7mm_P0.5mm
U2, U3: CD74HC4067SM; SSOP-24_5.3x8.2mm_P0.65mm
Y1: Crystal; Crystal_SMD_5032-2Pin_5.0x3.2mm

Connections:
+3V3: C2.1, C3.1, J2.4, J3.2, SW2.1 (A), U2.24 (VCC), U3.24 (VCC)
+5V: J2.3, J3.1, J5.1, SW1.1 (A)
/DEBUGRX: J1.6, U1.13 (PA3)
/DEBUGTX: J1.5, U1.12 (PA2)
/LIGHTGATE: J6.2, R33.1, U1.14 (PA4)
/MCU3V3: C4.2, C5.2, C6.2, FB1.1, R41.2, SW2.2 (B), U1.24 (VDD), U1.36 (VDD), U1.48 (VDD)
/MUX1OUT: R34.1, U1.10 (PA0), U2.1 (COM)
/MUX2OUT: R36.1, U1.11 (PA1), U3.1 (COM)
/OSCIN: C8.2, U1.5 (PD0), Y1.2
/OSCOUT: C9.2, U1.6 (PD1), Y1.1
/PROG3V3: J1.4, SW2.3 (C)
/RESET: R41.1, SW3.2, U1.7 (NRST)
/RX: J2.1, U1.31 (PA10)
/S0: U1.18 (PB0), U2.10 (S0), U3.10 (S0)
/S1: U1.19 (PB1), U2.11 (S1), U3.11 (S1)
/S2: U1.20 (PB2), U2.14 (S2), U3.14 (S2)
/S3: U1.21 (PB10), U2.13 (S3), U3.13 (S3)
/SOLENOIDON: Q2.1 (G), R44.1, U1.17 (PA7)
/SOLENOIDPOWER: C10.1, D34.2 (A), J4.1, SOLENOID1.1
/SWDCLOCK: J1.2, U1.37 (PA14)
/SWDIO: J1.3, U1.34 (PA13)
/TX: J2.2, U1.30 (PA9)
GND: C1.2, C4.1, C5.1, C6.1, C8.1, C9.1, C10.2, D1.1 (K), D2.1 (K), D3.1 (K), D4.1 (K), D5.1 (K), D6.1 (K), D7.1 (K), D8.1 (K), D9.1 (K), D10.1 (K), D11.1 (K), D12.1 (K), D13.1 (K), D14.1 (K), D15.1 (K), D16.1 (K), D17.1 (K), D18.1 (K), D19.1 (K), D20.1 (K), D21.1 (K), D22.1 (K), D23.1 (K), D24.1 (K), D25.1 (K), D26.1 (K), D27.1 (K), D28.1 (K), D29.1 (K), D30.1 (K), D31.1 (K), D32.1 (K), D33.1 (K), FB2.1, J1.1, J2.5, J3.3, J4.2, J5.2, Q2.2 (S), R38.2, R40.1, R44.2, U1.23 (VSS), U1.35 (VSS), U1.47 (VSS)
unnamed: C1.1, D1.2 (A), D2.2 (A), D3.2 (A), D4.2 (A), D5.2 (A), D6.2 (A), D7.2 (A), D8.2 (A), D9.2 (A), D10.2 (A), D11.2 (A), D12.2 (A), D13.2 (A), D14.2 (A), D15.2 (A), D16.2 (A), D17.2 (A), D18.2 (A), D19.2 (A), D20.2 (A), D21.2 (A), D22.2 (A), D23.2 (A), D24.2 (A), D25.2 (A), D26.2 (A), D27.2 (A), D28.2 (A), D29.2 (A), D30.2 (A), D31.2 (A), D32.2 (A), SW1.2 (B)
unnamed: C11.1, R45.2
unnamed: C11.2, Q1.3 (S), Q2.3 (D), R42.2
unnamed: D33.2 (A), R39.2
unnamed: D34.1 (K), D35.1 (K)
unnamed: D35.2 (A), Q1.2 (D), R45.1, SOLENOID1.2
unnamed: Q1.1 (G), R43.2
unnamed: R1.2, U2.9 (I0)
unnamed: R2.2, U2.8 (I1)
unnamed: R3.2, U2.7 (I2)
unnamed: R4.2, U2.6 (I3)
unnamed: R5.2, U2.5 (I4)
unnamed: R6.2, U2.4 (I5)
unnamed: R7.2, U2.3 (I6)
unnamed: R8.2, U2.2 (I7)
unnamed: R9.2, U2.23 (I8)
unnamed: R10.2, U2.22 (I9)
unnamed: R11.2, U2.21 (I10)
unnamed: R12.2, U2.20 (I11)
unnamed: R13.2, U2.19 (I12)
unnamed: R14.2, U2.18 (I13)
unnamed: R15.2, U2.17 (I14)
unnamed: R16.2, U2.16 (I15)
unnamed: R17.2, U3.9 (I0)
unnamed: R18.2, U3.8 (I1)
unnamed: R19.2, U3.7 (I2)
unnamed: R20.2, U3.6 (I3)
unnamed: R21.2, U3.5 (I4)
unnamed: R22.2, U3.4 (I5)
unnamed: R23.2, U3.3 (I6)
unnamed: R24.2, U3.2 (I7)
unnamed: R25.2, U3.23 (I8)
unnamed: R26.2, U3.22 (I9)
unnamed: R27.2, U3.21 (I10)
unnamed: R28.2, U3.20 (I11)
unnamed: R29.2, U3.19 (I12)
unnamed: R30.2, U3.18 (I13)
unnamed: R31.2, U3.17 (I14)
unnamed: R32.2, U3.16 (I15)
unnamed: R35.1, U2.15 (~E)
unnamed: R37.1, U3.15 (~E)
unnamed: R38.1, U1.44 (BOOT0)
unnamed: R39.1, U1.15 (PA5)
unnamed: R40.2, SW3.1
unnamed: R42.1, R43.1
VCCQ: C7.1, FB1.2, J6.1, R1.1, R2.1, R3.1, R4.1, R5.1, R6.1, R7.1, R8.1, R9.1, R10.1, R11.1, R12.1, R13.1, R14.1, R15.1, R16.1, R17.1, R18.1, R19.1, R20.1, R21.1, R22.1, R23.1, R24.1, R25.1, R26.1, R27.1, R28.1, R29.1, R30.1, R31.1, R32.1, U1.9 (VDDA)

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
