8076ducc/robocup-2023/electrical design/layer1/layer1.kicad_pcb

## KiCad design electrical design/layer1/layer1.kicad_pcb (continued)

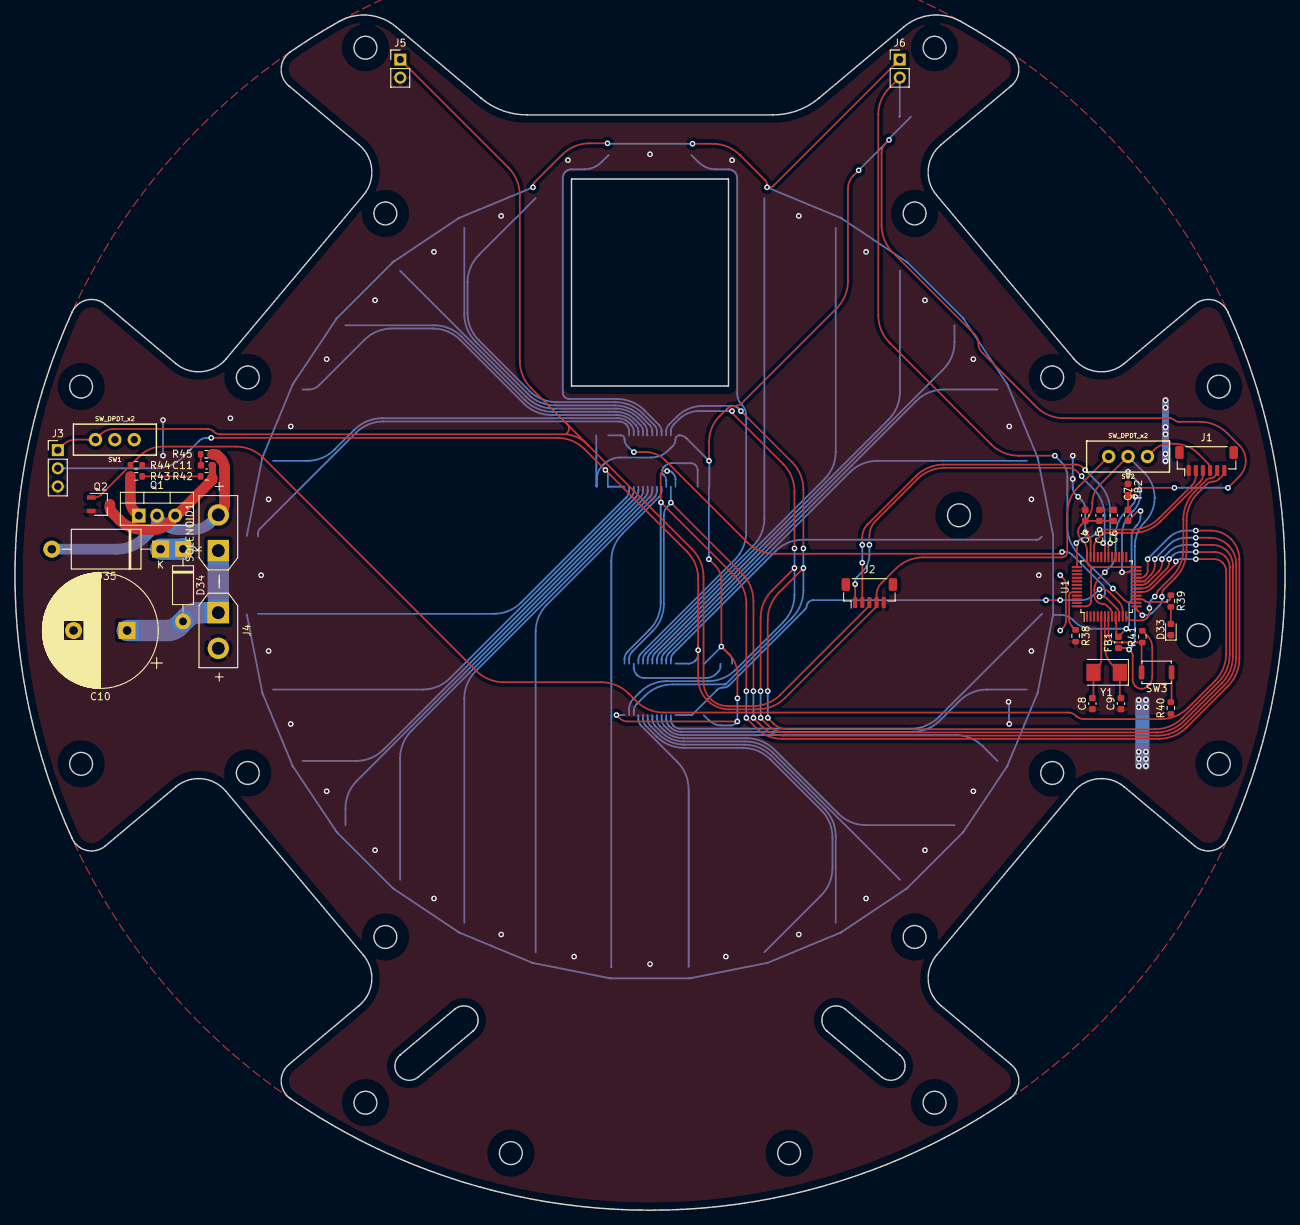
[picture p44: board layer1.kicad_pcb from above]

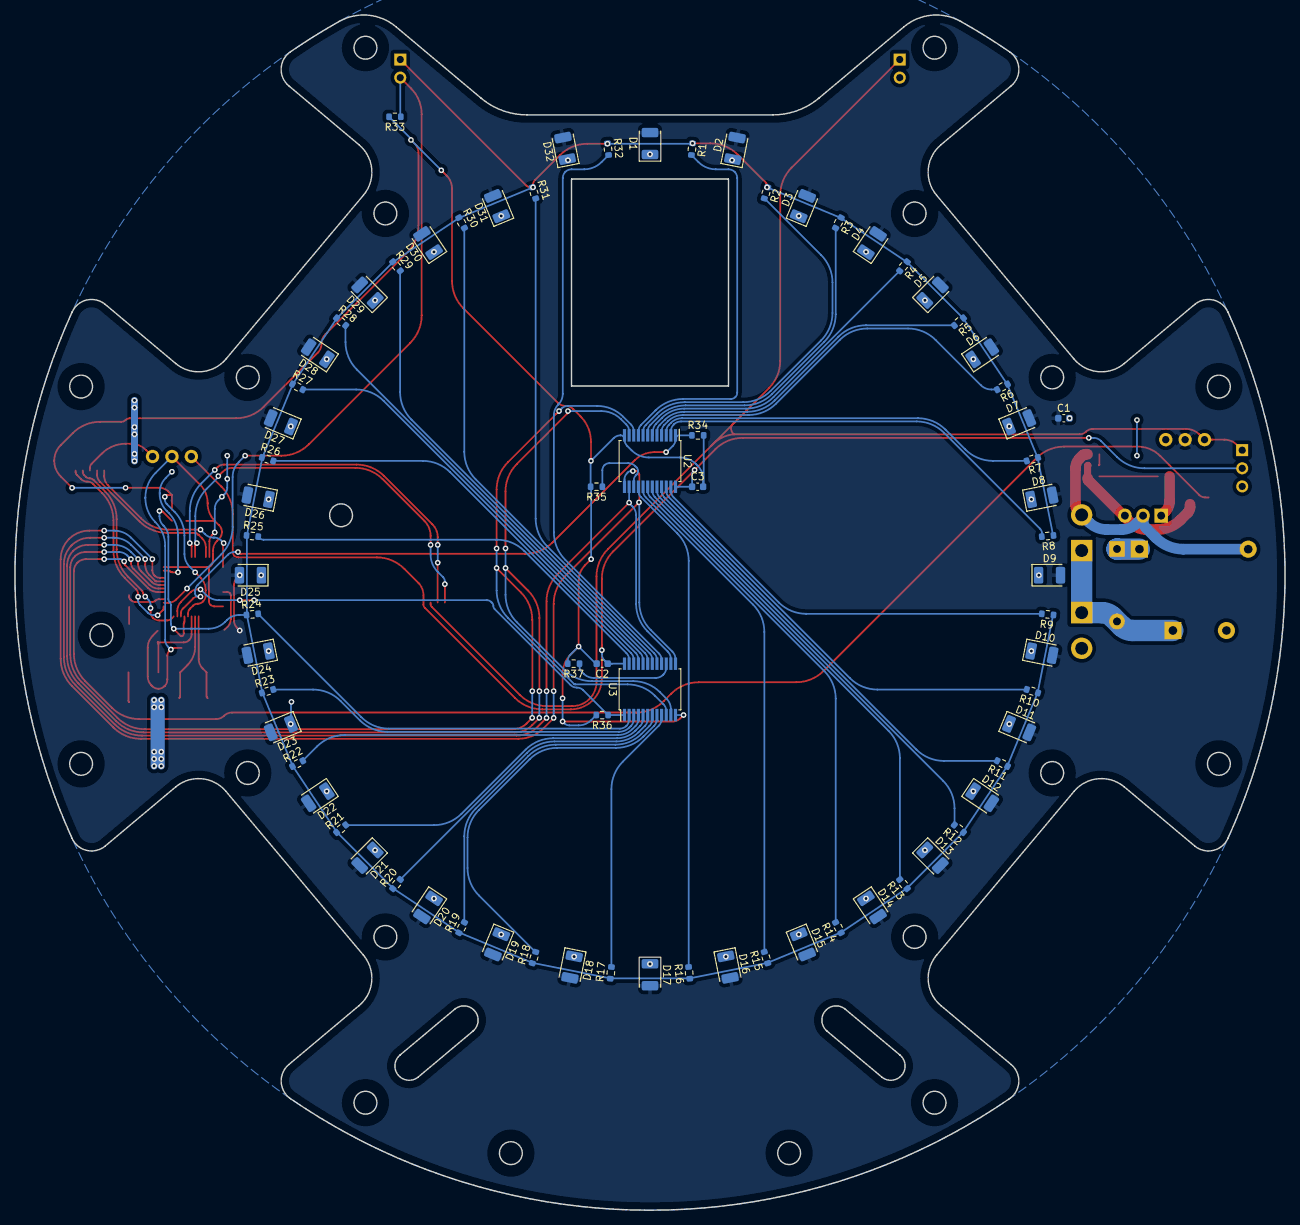
[picture p45: board layer1.kicad_pcb from below]

Board: 2 copper layers, 178.0 x 167.5 mm, 109 parts (74 on the bottom side), 70 nets.
