8076ducc/robocup-2023/programming/teensy/src/main.h

#ifndef main.h
#define main.h

#include <Arduino.h>

#define led 13

#define m1PWM 2
#define m2PWM 3
#define m3PWM 4
#define m4PWM 5
#define lidarPWM 6
#define dribblerPWM 18

#define m1INA 9
#define m2INA 10
#define m3INA 11
#define m4INA 12

#define L1SERIAL Serial1
#define L4SERIAL Serial2
#define IMUSERIAL Serial3
#define BTSERIAL Serial4
#define CAMSERIAL Serial5

#endif
