8076ducc/robocup-2023/programming/stm32b/src/main.h

#ifndef main.h
#define main.h

#include <Arduino.h>
#include "../include/config.h"

#define led PB2

#define M1C1 PA0
#define M1C2 PA1
#define M2C1 PA4
#define M2C2 PA5
#define M3C1 PA6
#define M3C2 PA7
#define M4C1 PB0
#define M4C2 PB1

#endif
