8076ducc/robocup-2023/programming/stm32a/src/main.h

#ifndef main.h
#define main.h

#define botA

#include <Arduino.h>

#define led PA5

#define s0 PB0
#define s1 PB1
#define s2 PB2
#define s3 PB10

#define mux1 PA0
#define mux2 PA1
#define lightgate PA4

#define solenoid PA7

#define TEENSY Serial1
#define DEBUG Serial2

#endif
