8076ducc/robocup-2023/(commit log)

2022-08-24 add vnh5050a-e library
    [VNH5050A-E.step]
2022-08-24 complete vnh5050a test board
    [VNH5050A-test-B_Cu.gbl, VNH5050A-test-B_Mask.gbs, VNH5050A-test-B_Paste.gbp, VNH5050A-test-B_Silkscreen.gbo, VNH5050A-test-Edge_Cuts.gm1, VNH5050A-test-F_Cu.gtl, VNH5050A-test-F_Mask.gts, VNH5050A-test-F_Paste.gtp]
2022-08-24 start work on layer 1 pcb
    [layer1.kicad_pcb, layer1.kicad_sch]
2022-08-24 add stm32f103cbt6 library
    [STM32F103CBT6.step]
2022-08-25 finish dribbler plates
    [gearbox-cover.stl, left-plate.stl, right-plate.stl]
2022-08-26 update dribbler plates after changing gear positions
    [gearbox-cover.stl, left-plate.stl, right-plate.stl]
2022-08-27 add roller for 12mm o-ring
    [roller.stl]
2022-08-31 update dribbler motor mount and omniwheel folder
    [right-plate.stl, roller.stl]
2022-12-02 begin schematic design for layer 1 pcb
    [layer1.kicad_sch]
2022-12-02 finish stm32f103c8t6 sub-circuit
    [layer1.kicad_sch]
2022-12-02 add power input to layer 1
    [layer1.kicad_sch]
2022-12-02 add layer 2 pcb files
    [layer2.kicad_pcb, layer2.kicad_sch]
2022-12-02 add layer 3 pcb files
    [layer3.kicad_pcb, layer3.kicad_sch]
2022-12-02 change faulty silkscreen on driver test board
    [VNH5050A-test.kicad_pcb]
2022-12-04 groundwork for layer 2 pcb
    [layer2.kicad_sch]
2022-12-04 update layer 1 files
    [layer1.kicad_sch]
2022-12-04 add teensy 4.0 symbol and footprints
2022-12-04 add omniwheel mesh files
    [layer1.stl, layer2.stl, layer3.stl, layer4.stl]
2022-12-05 rename files
    [layer1.kicad_pcb, layer1.kicad_sch, layer2.kicad_pcb, layer2.kicad_sch, layer3.kicad_sch, layer4.kicad_pcb, layer4.kicad_sch]
2022-12-05 add support for bldc esc
    [layer3.kicad_sch]
2022-12-05 fix faulty esc connection
    [layer3.kicad_sch]
2022-12-14 update layer 1 and 3 schematics
    [layer1.kicad_sch, layer3.kicad_sch]
2023-01-07 assign footprints and update layer 1 pcb
    [layer1.kicad_pcb, layer1.kicad_sch]
2023-01-10 add solenoid circuit and custom board rules
    [layer1.kicad_pcb, layer1.kicad_sch]
2023-01-24 update layer 1 and layer 3 pcbs
    [layer1.kicad_pcb, layer1.kicad_sch, layer3.kicad_sch]
2023-01-26 update omniwheel roller and add 2023 motors mounts
    [motor mount (lower half).stl, motor mount (upper half).stl, roller.stl]
2023-01-28 finish finalised VNH5050A breakout board
    [VNH5050A-test-B_Cu.gbl, VNH5050A-test-B_Mask.gbs, VNH5050A-test-B_Paste.gbp, VNH5050A-test-B_Silkscreen.gbo, VNH5050A-test-Edge_Cuts.gm1, VNH5050A-test-F_Cu.gtl, VNH5050A-test-F_Mask.gts, VNH5050A-test-F_Paste.gtp]
2023-01-28 update motor mount and roller mesh files
    [motor mount (upper half).stl, roller.stl]
2023-01-28 add driver board design pdfs
2023-01-29 finalise l4 sch, start draft of l4 pcb
    [layer4.kicad_pcb, layer4.kicad_sch]
2023-01-29 add layer 1 pcb rules
2023-01-29 increase size of driver output polygon
    [driver.kicad_pcb]
2023-01-29 almost final layer 3 pcb design
    [layer3.kicad_pcb, layer3.kicad_sch]
2023-01-29 add symbol and footprint libraries
2023-01-29 add sparkfun and teensy libraries
    [_saved_boostboard1.sch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]
2023-02-03 update l1, l3, and driver pcbs
    [driver.kicad_pcb, layer1.kicad_pcb, layer1.kicad_sch, layer3.kicad_pcb, layer3.kicad_sch]
2023-02-03 add xt30pw-m kicad library
    [XT60PW-M.step]
2023-02-05 almost final pcbs
    [layer1.kicad_pcb, layer1.kicad_sch, layer3.kicad_pcb, layer3.kicad_sch, layer4.kicad_sch]
2023-02-05 add teensy library
2023-02-12 production ready layer 4!
    [layer4.kicad_pcb, layer4.kicad_sch]
2023-02-12 rename all layer 4 files to layer 5
    [layer5.kicad_pcb, layer5.kicad_sch]
2023-02-15 add pcb cutouts
    [layer1.dxf, layer3.dxf, layer5.dxf]
2023-02-15 production-ready layer 1!
    [layer1.kicad_pcb, layer1.kicad_sch]
2023-02-24 submit all pcbs for production
    [driver-B_Cu.gbl, driver-B_Mask.gbs, driver-B_Paste.gbp, driver-B_Silkscreen.gbo, driver-Edge_Cuts.gm1, driver-F_Cu.gtl, driver-F_Mask.gts, driver-F_Paste.gtp]
2023-04-07 teensy program files
2023-04-07 layer 1 stm32 program files
2023-04-07 layer 2 stm32 (1) program files
2023-04-07 layer 2 stm32 (2) program files
2023-04-07 update omniwheel design files
    [layer1.stl, layer2.stl, layer3.stl, layer4.stl, motor mount (lower half).stl, motor mount (upper half).stl, omniwheel layer 1.stl, omniwheel layer 2.stl]
2023-04-10 update board outline files
    [driver.dxf, layer5.dxf]
2023-04-17 fillet pcb traces
    [driver.kicad_pcb, layer1.kicad_pcb, layer3.kicad_pcb, layer5.kicad_pcb]
