8076ducc/robocup-2023/(notices)

Notices in the files:
electrical design/symbols and footprints/SparkFun-KiCad-Libraries/Documentation/Example Project/_saved_boostboard1.sch:
Released under the Creative Commons share-Alike 4.0
